Charading/VLT/CAD/drawings/SelfClinchStandoff.png

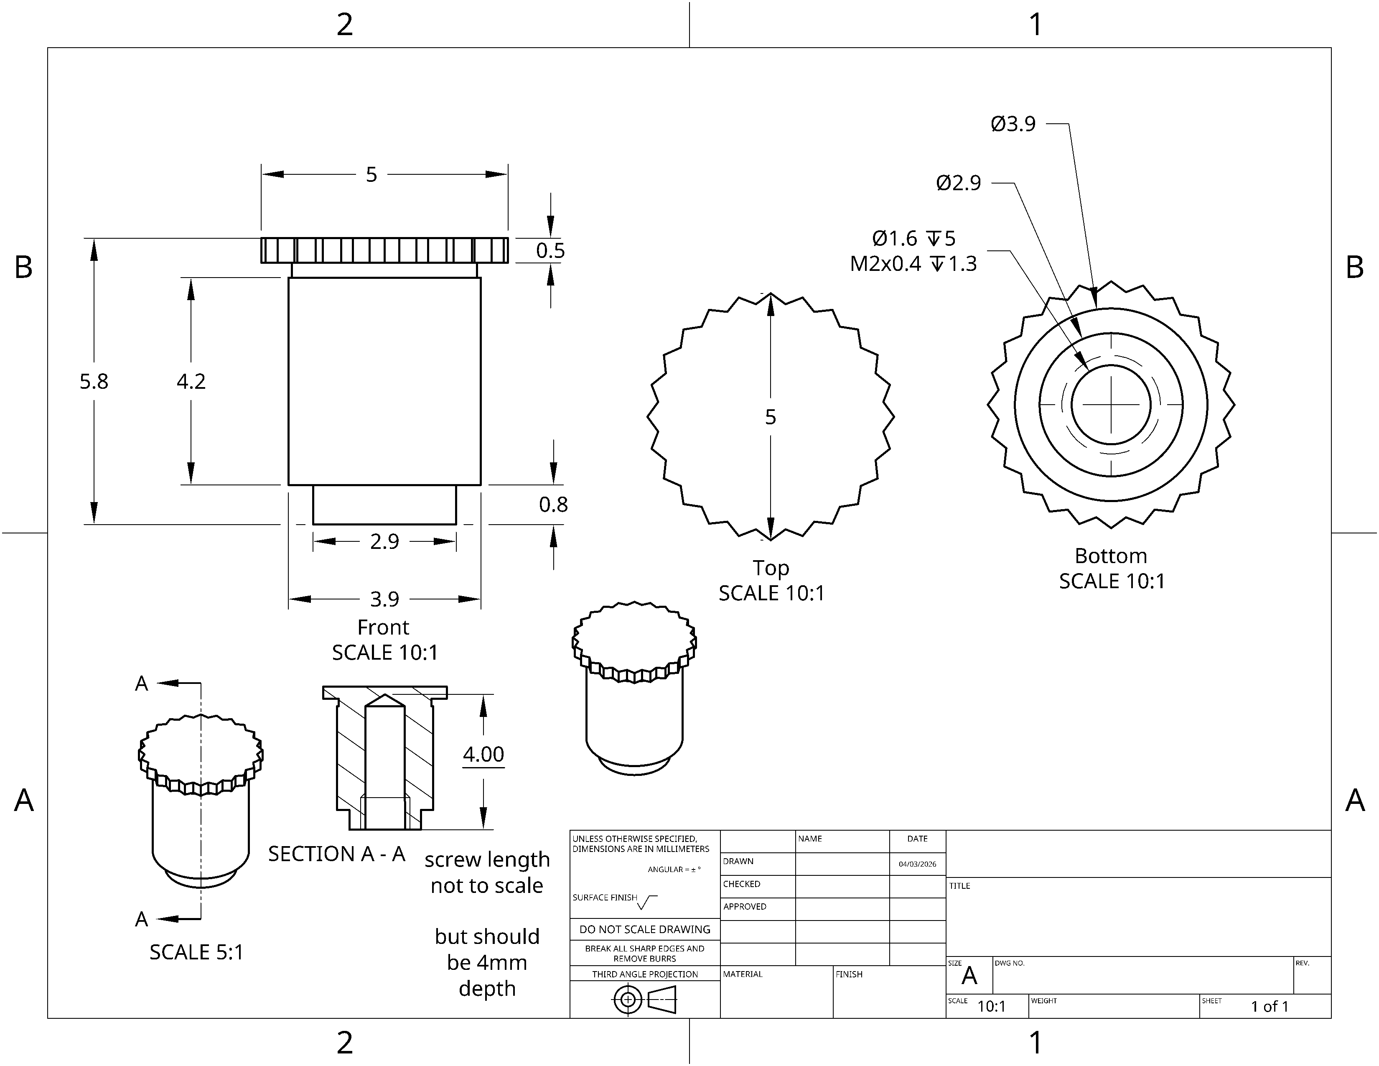
CAD/drawings/SelfClinchStandoff.png
