Charading/VLT/VLT_plate.dxf

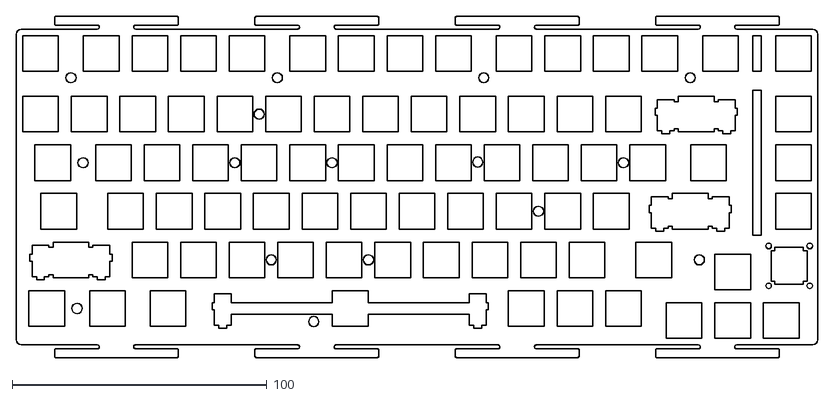
[picture p2: CAD file, 2026-02-06]
VLT_plate.dxf
314.3 x 133.8
