Charading/VLT/CAD/drawings/led cUTOUT.dxf

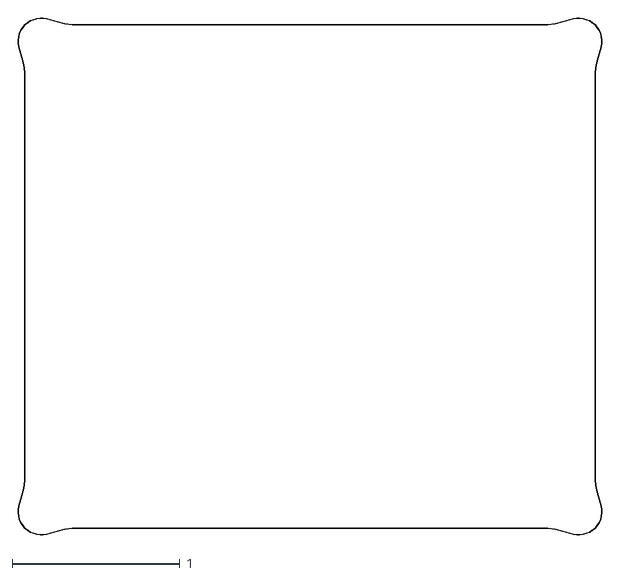
[picture p3: CAD file, 2026-04-27]
CAD/drawings/led cUTOUT.dxf
3.50 x 3.10
