Charading/VLT/(list of files, cad)

Other CAD files:
CAD/drawings/SelfClinchStandoff.dwg
