Charading/VLT/VLT.kicad_sch

## KiCad design VLT.kicad_sch (2026-04-27)

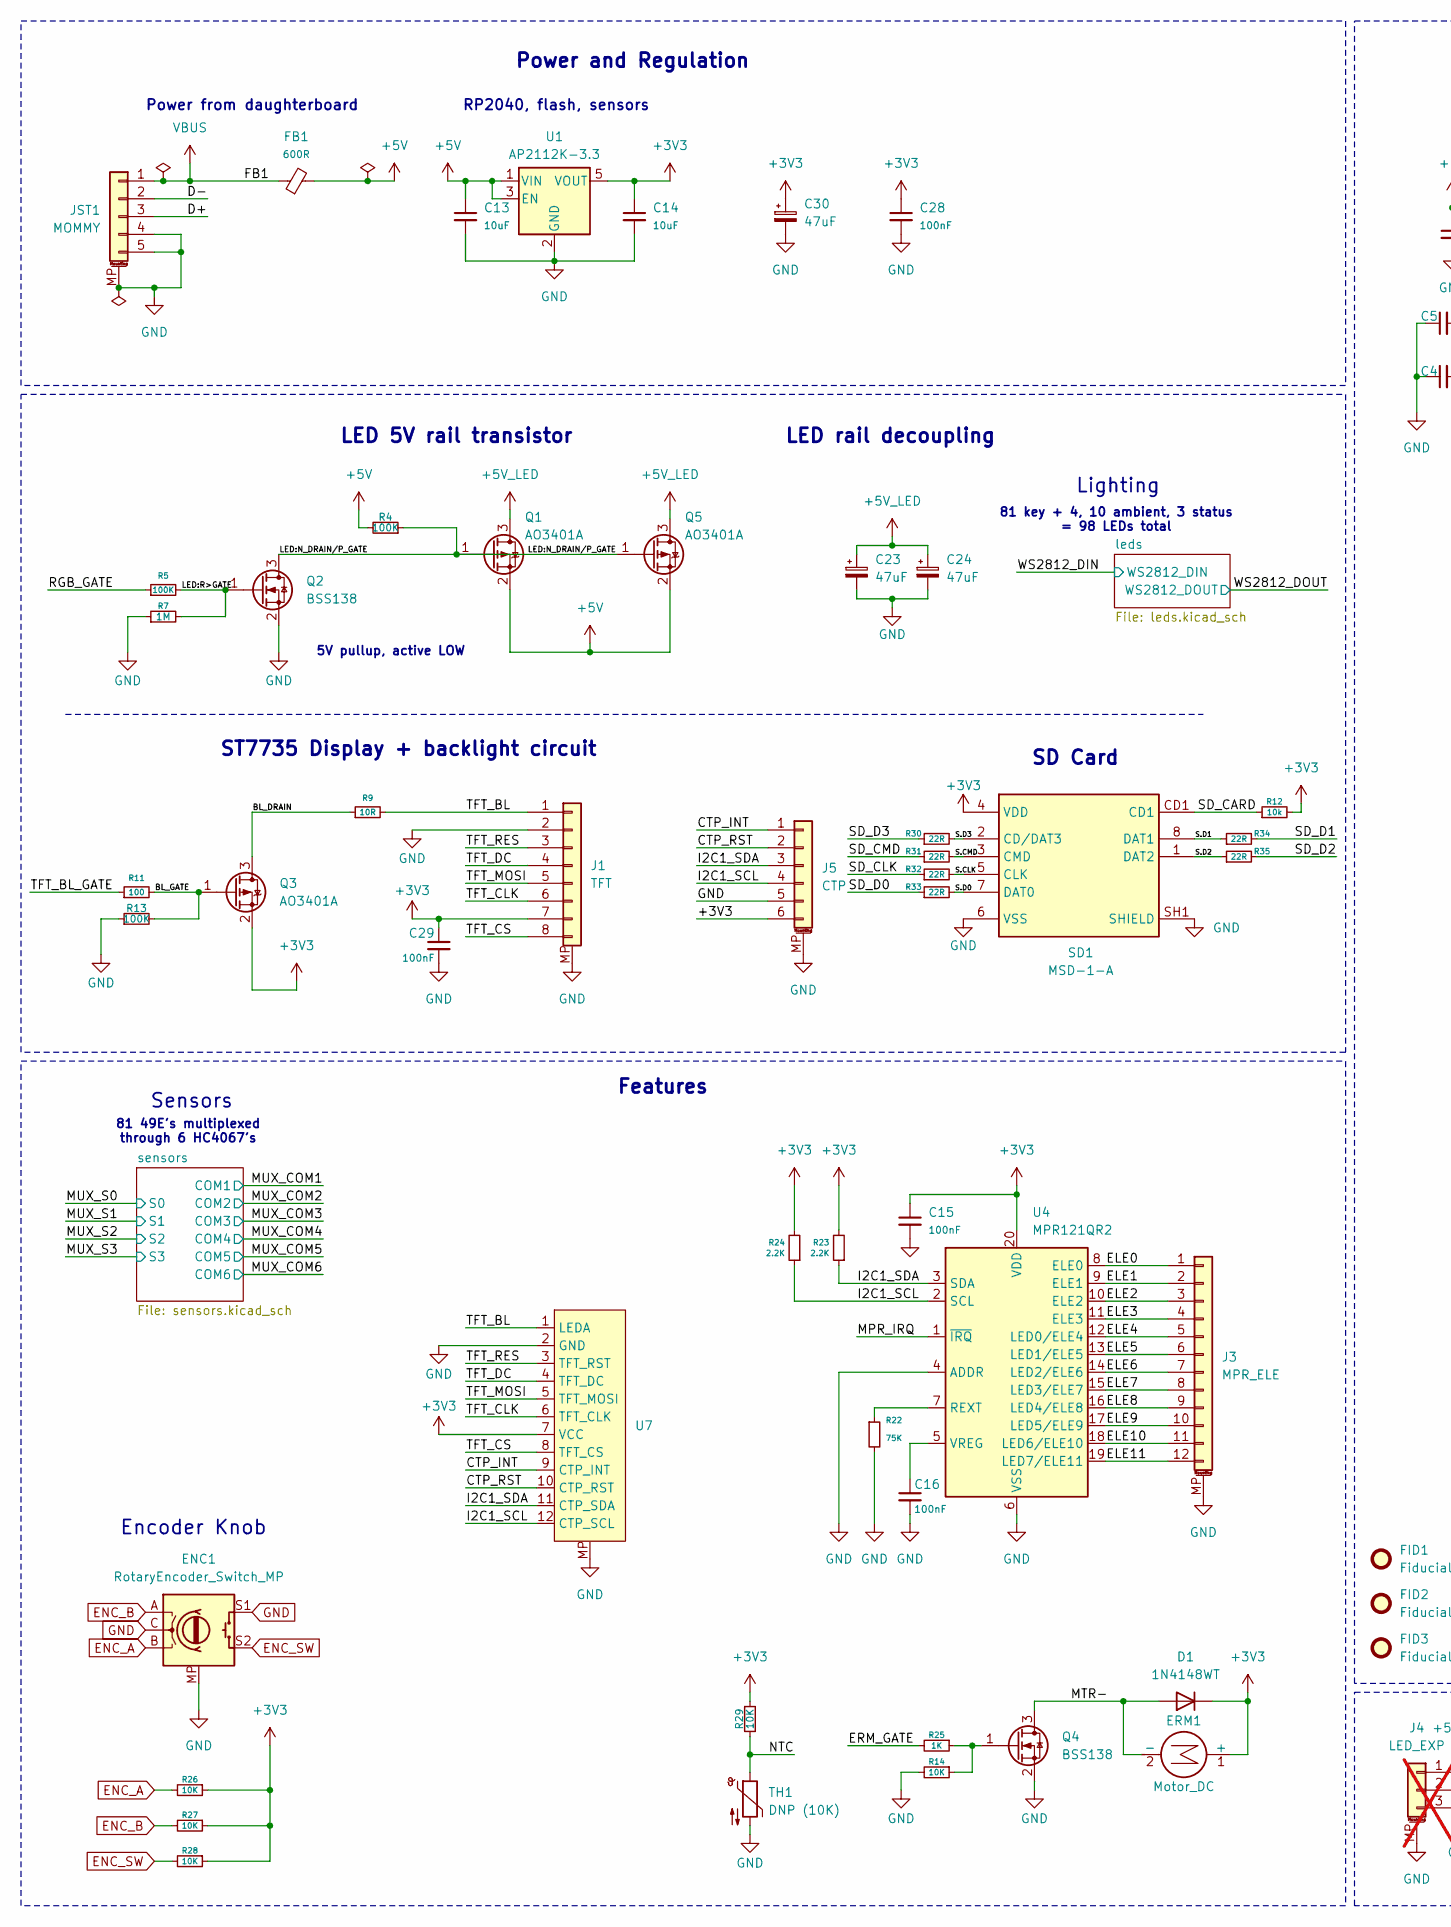
[picture p4: schematic VLT.kicad_sch, part in row 1, column 1]

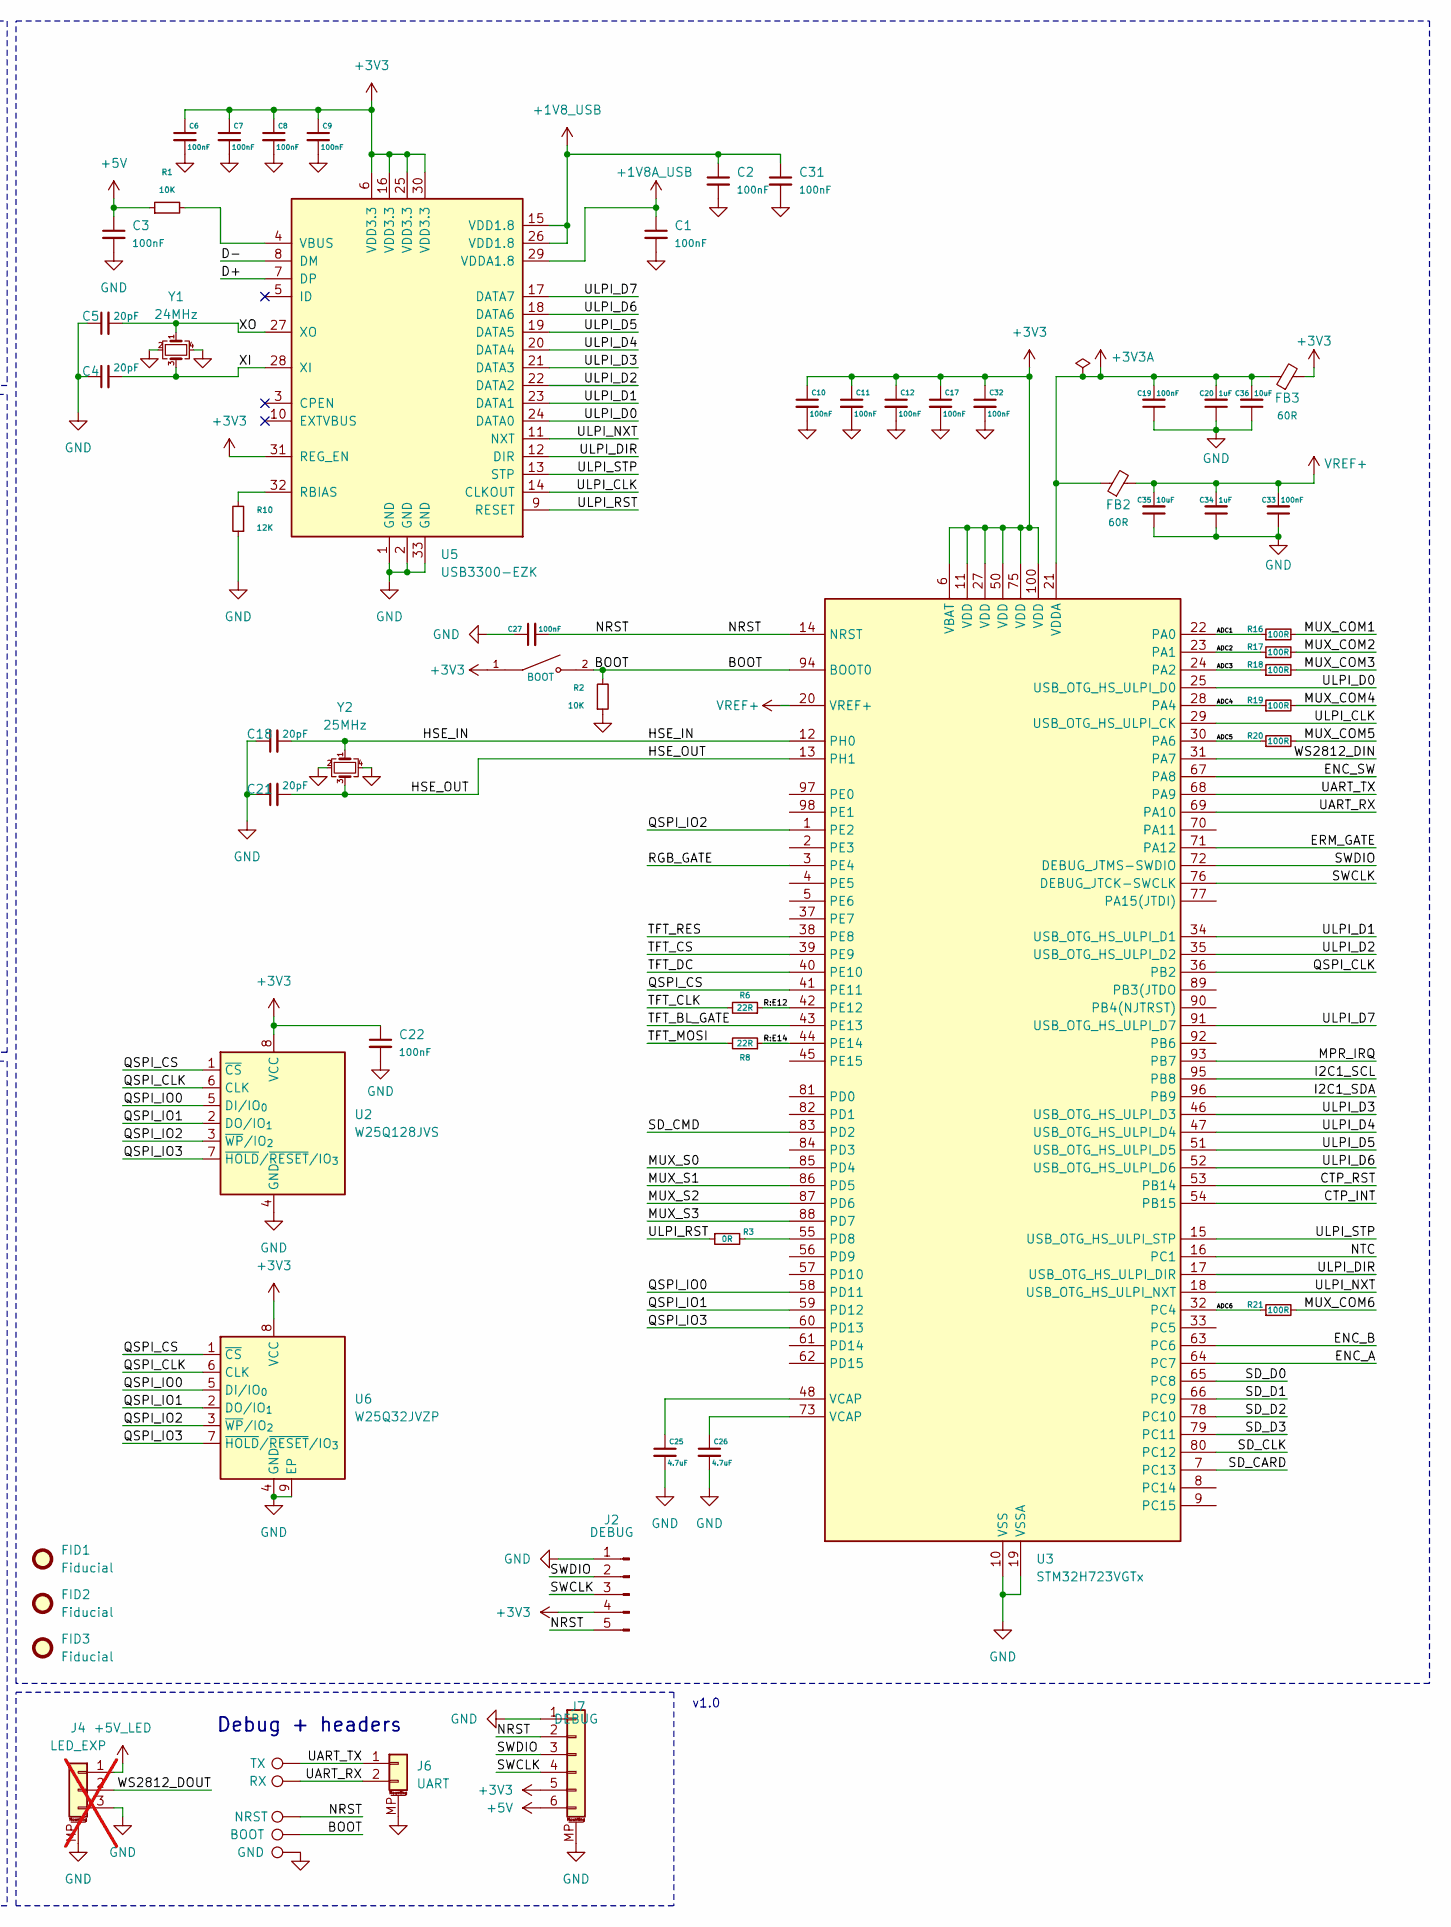
[picture p5: schematic VLT.kicad_sch, part in row 1, column 2]

Parts:
C1, C2, C3, C6, C7, C8, C9, C10, C11, C12, C17, C27, C31, C32: 100nF; C_0402; LCSC C14663
C4, C5, C18, C21: 20pF; C_0402
C13, C14: 10uF; C_0603; LCSC C19702
C15, C16, C28, C29: 100nF; C_0603; LCSC C14663
C19, C33: 100nF; C_0402; Manufacturer Part CL05B104KO5NNNC; LCSC Part Name 100nF ±10% 16V
C20, C34: 1uF; C_0402; Manufacturer Part CL05B104KO5NNNC; LCSC Part Name 100nF ±10% 16V
C22: 100nF; C_0402
C23, C24, C30: 47uF; CP_EIA-3216-12_Kemet-S
C25, C26: 4.7uF; C_0402; LCSC C23733
C35, C36: 10uF; C_0402; Manufacturer Part CL05B104KO5NNNC; LCSC Part Name 100nF ±10% 16V
D1: 1N4148WT; D_SOD-523
ENC1: RotaryEncoder_Switch_MP; RotaryEncoder_Alps_EC11E_Vertical_H20mm_CircularMountingHol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
ERM1: Motor_DC; Coin_Motor_ERM_10mm
FB1: 600R; Ferrite_0805; LCSC C1002
FB2, FB3: 60R; Ferrite_0402
FID1, FID2, FID3: Fiducial; Fiducial_0.5mm_Mask1mm
J1: TFT; XUNPU_FPC-05F-8PH20_1x8-1MP_P0.5mm
J2: DEBUG; SWD_Debug_PinHeader_1x05_P2.54mm; Part Number 1-0401FBV0T
J3: MPR_ELE; XUNPU_FPC-05F-12PH20_1x12-1MP_P0.5mm
J4: LED_EXP; JST_GH_SM03B-GHS-TB_1x03-1MP_P1.25mm_Horizontal; not fitted
J5: CTP; XUNPU_FPC-05F-6PH20_1x6-1MP_P0.5mm
J6: UART; JST_SH_SM02B-SRSS-TB_1x02-1MP_P1.00mm_Horizontal
J7: DEBUG; JST_SH_SM06B-SRSS-TB_1x06-1MP_P1.00mm_Horizontal; Part Number 1-0401FBV0T
JST1: MOMMY; JST_GH_SM05B-GHS-TB_1x05-1MP_P1.25mm_Horizontal
Q1, Q3, Q5: AO3401A; SOT-23
Q2, Q4: BSS138; SOT-23
R1, R2: 10K; R_0402
R3: 0R; R_0402; LCSC C25076
R4, R5, R13: 100K; R_0603
R6, R8, R30, R31, R32, R33, R34, R35: 22R; R_0402
R7: 1M; R_0603
R9: 10R; R_0603; LCSC C22859
R10: 12K; R_0402
R11: 100; R_0603
R12: 10k; R_0603
R14: 10K; R_0402; LCSC C25744
R16, R17, R18, R19, R20, R21: 100R; R_0402; LCSC C25076
R22: 75K; R_0603
R23, R24: 2.2K; R_0402
R25: 1K; R_0402; LCSC C11702
R26, R27, R28, R29: 10K; R_0603; LCSC C25804
S1: BOOT; SW_B3U-1000P
SD1: MSD-1-A; MSD1A; Manufacturer_Part_Number MSD-1-A; Mouser Part Number 179-MSD-1-A
TH1: DNP (10K); R_0603
TP1: TX; TestPoint_Pad_D1.0mm_Minimal
TP2: RX; TestPoint_Pad_D1.0mm_Minimal
TP3: NRST; TestPoint_Pad_D1.0mm_Minimal
TP4: BOOT; TestPoint_Pad_D1.0mm_Minimal
TP5: GND; TestPoint_Pad_D1.0mm_Minimal
U1: AP2112K-3.3; SOT-23-5; LCSC C23380830
U2: W25Q128JVS; SOIC-8_5.3x5.3mm_P1.27mm; LCSC C97521
U3: STM32H723VGTx; LQFP-100_14x14mm_P0.5mm
U4: MPR121QR2; UQFN-20_3x3mm_P0.4mm
U5: USB3300-EZK; QFN-32-1EP_5x5mm_P0.5mm_EP3.45x3.45mm
U6: W25Q32JVZP; WSON-8-1EP_6x5mm_P1.27mm_EP3.4x4.3mm
U7: XUNPU_FPC-05F-12PH20_1x12-1MP_P0.5mm
Y1: 24MHz; Crystal_SMD_3225-4Pin_3.2x2.5mm
Y2: 25MHz; Crystal_SMD_3225-4Pin_3.2x2.5mm

Connections:
+1V8A_USB: C1.1, U5.29 (VDDA1.8)
+1V8_USB: C2.1, C31.1, U5.15 (VDD1.8), U5.26 (VDD1.8)
+3V3: C6.1, C7.1, C8.1, C9.1, C10.1, C11.1, C12.1, C14.1, C15.1, C17.1, C22.1, C28.1, C29.1, C30.1, C32.1, D1.1 (K), ERM1.1 (+), FB3.2, J1.7 (VDD), J2.4, J5.6, J7.5, Q3.2 (S), R12.2, R23.2, R24.2, R26.1, R27.1, R28.1, R29.1, S1.1, SD1.4 (VDD), U1.5 (VOUT), U2.8 (VCC), U3.6 (VBAT), U3.11 (VDD), U3.27 (VDD), U3.50 (VDD), U3.75 (VDD), U3.100 (VDD), U4.20 (VDD), U5.6 (VDD3.3), U5.16 (VDD3.3), U5.25 (VDD3.3), U5.30 (VDD3.3), U5.31 (REG_EN), U6.8 (VCC), U7.7 (VCC)
+3V3A: C19.2, C20.2, C36.2, FB2.1, FB3.1, U3.21 (VDDA)
+5V: C3.1, C13.1, FB1.2, J7.6, Q1.2 (S), Q5.2 (S), R1.1, R4.2, U1.1 (VIN), U1.3 (EN)
+5V_LED: C23.1, C24.1, J4.1, Q1.3 (D), Q5.3 (D)
ADC1: R16.1, U3.22 (PA0)
ADC2: R17.1, U3.23 (PA1)
ADC3: R18.1, U3.24 (PA2)
ADC4: R19.1, U3.28 (PA4)
ADC5: R20.1, U3.30 (PA6)
ADC6: R21.1, U3.32 (PC4)
BL_DRAIN: Q3.3 (D), R9.1
BL_GATE: Q3.1 (G), R11.2, R13.2
BOOT: R2.2, S1.2, TP4.1, U3.94 (BOOT0)
CTP_INT: J5.1, U3.54 (PB15), U7.9 (CTP_INT)
CTP_RST: J5.2, U3.53 (PB14), U7.10 (CTP_RST)
D+: JST1.3, U5.7 (DP)
D-: JST1.2, U5.8 (DM)
ELE0: J3.1, U4.8 (ELE0)
ELE1: J3.2, U4.9 (ELE1)
ELE2: J3.3, U4.10 (ELE2)
ELE3: J3.4, U4.11 (ELE3)
ELE4: J3.5, U4.12 (LED0/ELE4)
ELE5: J3.6, U4.13 (LED1/ELE5)
ELE6: J3.7, U4.14 (LED2/ELE6)
ELE7: J3.8, U4.15 (LED3/ELE7)
ELE8: J3.9, U4.16 (LED4/ELE8)
ELE9: J3.10, U4.17 (LED5/ELE9)
ELE10: J3.11, U4.18 (LED6/ELE10)
ELE11: J3.12, U4.19 (LED7/ELE11)
ENC_A: ENC1.B, R26.2, U3.64 (PC7)
ENC_B: ENC1.A, R27.2, U3.63 (PC6)
ENC_SW: ENC1.S2, R28.2, U3.67 (PA8)
ERM_GATE: R25.2, U3.71 (PA12)
GND: C1.2, C2.2, C3.2, C4.1, C5.1, C6.2, C7.2, C8.2, C9.2, C10.2, C11.2, C12.2, C13.2, C14.2, C15.2, C16.2, C17.2, C18.1, C19.1, C20.1, C21.1, C22.2, C23.2, C24.2, C25.2, C26.2, C27.1, C28.2, C29.2, C30.2, C31.2, C32.2, C33.1, C34.1, C35.1, C36.1, ENC1.C, ENC1.MP, ENC1.S1, J1.2 (GND), J1.MP (Pin_8), J2.1, J3.MP (MountPin), J4.3, J4.MP (MountPin), J5.5, J5.MP (MountPin), J6.MP (MountPin), J7.1, J7.MP (MountPin), JST1.4, JST1.5, JST1.MP (MountPin), Q2.2 (S), Q4.2 (S), R2.1, R7.1, R10.1, R13.1, R14.2, R22.2, SD1.6 (VSS), SD1.9 (GND_1), SD1.10 (GND_2), SD1.11 (GND_3), SD1.12 (GND_4), SD1.SH1 (SHIELD), TH1.2, TP5.1, U1.2 (GND), U2.4 (GND), U3.10 (VSS), U3.19 (VSSA), U3.26 (VSS), U3.49 (VSS), U3.74 (VSS), U3.99 (VSS), U4.4 (ADDR), U4.6 (VSS), U5.1 (GND), U5.2 (GND), U5.33 (GND), U6.4 (GND), U6.9 (EP), U7.2 (GND), U7.MP, Y1.2, Y1.4, Y2.2, Y2.4
HSE_IN: C18.2, U3.12 (PH0), Y2.1
HSE_OUT: C21.2, U3.13 (PH1), Y2.3
I2C1_SCL: J5.4, R24.1, U3.95 (PB8), U4.2 (SCL), U7.12 (CTP_SCL)
I2C1_SDA: J5.3, R23.1, U3.96 (PB9), U4.3 (SDA), U7.11 (CTP_SDA)
LED:N_DRAIN/P_GATE: Q1.1 (G), Q2.3 (D), Q5.1 (G), R4.1
LED:R>GATE: Q2.1 (G), R5.2, R7.2
MPR_IRQ: U3.93 (PB7), U4.1 (~IRQ)
MTR-: D1.2 (A), ERM1.2 (-), Q4.3 (D)
MUX_COM1: R16.2
MUX_COM2: R17.2
MUX_COM3: R18.2
MUX_COM4: R19.2
MUX_COM5: R20.2
MUX_COM6: R21.2
MUX_S0: U3.85 (PD4)
MUX_S1: U3.86 (PD5)
MUX_S2: U3.87 (PD6)
MUX_S3: U3.88 (PD7)
NRST: C27.2, J2.5, J7.2, TP3.1, U3.14 (NRST)
NTC: R29.2, TH1.1, U3.16 (PC1)
unnamed: C16.1, U4.5 (VREG)
unnamed: C25.1, U3.48 (VCAP)
unnamed: C26.1, U3.73 (VCAP)
unnamed: Q4.1 (G), R14.1, R25.1
unnamed: R1.2, U5.4 (VBUS)
unnamed: R3.2, U3.55 (PD8)
unnamed: R10.2, U5.32 (RBIAS)
unnamed: R22.1, U4.7 (REXT)
QSPI_CLK: U2.6 (CLK), U3.36 (PB2), U6.6 (CLK)
QSPI_CS: U2.1 (~CS), U3.41 (PE11), U6.1 (~CS)
QSPI_IO0: U2.5 (DI/IO_{0}), U3.58 (PD11), U6.5 (DI/IO_{0})
QSPI_IO1: U2.2 (DO/IO_{1}), U3.59 (PD12), U6.2 (DO/IO_{1})
QSPI_IO2: U2.3 (~WP/IO_{2}), U3.1 (PE2), U6.3 (~WP/IO_{2})
QSPI_IO3: U2.7 (~HOLD/~RESET/IO_{3}), U3.60 (PD13), U6.7 (~HOLD/~RESET/IO_{3})
R:E12: R6.1, U3.42 (PE12)
R:E14: R8.1, U3.44 (PE14)
RGB_GATE: R5.1, U3.3 (PE4)
S.CLK: R32.2, SD1.5 (CLK)
S.CMD: R31.2, SD1.3 (CMD)
S.D0: R33.2, SD1.7 (DAT0)
S.D1: R34.1, SD1.8 (DAT1)
S.D2: R35.1, SD1.1 (DAT2)
S.D3: R30.2, SD1.2 (CD/DAT3)
SD_CARD: R12.1, SD1.CD1, U3.7 (PC13)
SD_CLK: R32.1, U3.80 (PC12)
SD_CMD: R31.1, U3.83 (PD2)
SD_D0: R33.1, U3.65 (PC8)
SD_D1: R34.2, U3.66 (PC9)
SD_D2: R35.2, U3.78 (PC10)
SD_D3: R30.1, U3.79 (PC11)
SWCLK: J2.3, J7.4, U3.76 (PA14(JTCK)
SWDIO: J2.2, J7.3, U3.72 (PA13(JTMS)
TFT_BL: J1.1 (LEDA), R9.2, U7.1 (LEDA)
TFT_BL_GATE: R11.1, U3.43 (PE13)
TFT_CLK: J1.6 (SCL), R6.2, U7.6 (TFT_CLK)
TFT_CS: J1.8 (CS), U3.39 (PE9), U7.8 (TFT_CS)
TFT_DC: J1.4 (DC), U3.40 (PE10), U7.4 (TFT_DC)
TFT_MOSI: J1.5 (SDA), R8.2, U7.5 (TFT_MOSI)
TFT_RES: J1.3 (RES), U3.38 (PE8), U7.3 (TFT_RST)
UART_RX: J6.2, TP2.1, U3.69 (PA10)
UART_TX: J6.1, TP1.1, U3.68 (PA9)
ULPI_CLK: U3.29 (PA5), U5.14 (CLKOUT)
ULPI_D0: U3.25 (PA3), U5.24 (DATA0)
ULPI_D1: U3.34 (PB0), U5.23 (DATA1)
ULPI_D2: U3.35 (PB1), U5.22 (DATA2)
ULPI_D3: U3.46 (PB10), U5.21 (DATA3)
ULPI_D4: U3.47 (PB11), U5.20 (DATA4)
ULPI_D5: U3.51 (PB12), U5.19 (DATA5)
ULPI_D6: U3.52 (PB13), U5.18 (DATA6)
ULPI_D7: U3.91 (PB5), U5.17 (DATA7)
ULPI_DIR: U3.17 (PC2_C), U5.12 (DIR)
ULPI_NXT: U3.18 (PC3_C), U5.11 (NXT)
ULPI_RST: R3.1, U5.9 (RESET)
ULPI_STP: U3.15 (PC0), U5.13 (STP)
VBUS: FB1.1, JST1.1
VREF+: C33.2, C34.2, C35.2, FB2.2, U3.20 (VREF+)
WS2812_DIN: U3.31 (PA7)
WS2812_DOUT: J4.2
XI: C4.2, U5.28 (XI), Y1.3
XO: C5.2, U5.27 (XO), Y1.1

Notes on the sheet:
LED 5V rail transistor
Power and Regulation
Features
Sensors
RP2040, flash, sensors
ST7735 Display + backlight circuit
v1.0
Debug + headers
5V pullup, active LOW
Power from daughterboard
SD Card
Lighting
LED rail decoupling
81 49E's multiplexed through 6 HC4067's
Encoder Knob
81 key + 4, 10 ambient, 3 status = 98 LEDs total
