Charading/VLT/leds.kicad_sch

## KiCad design leds.kicad_sch (2026-04-27)

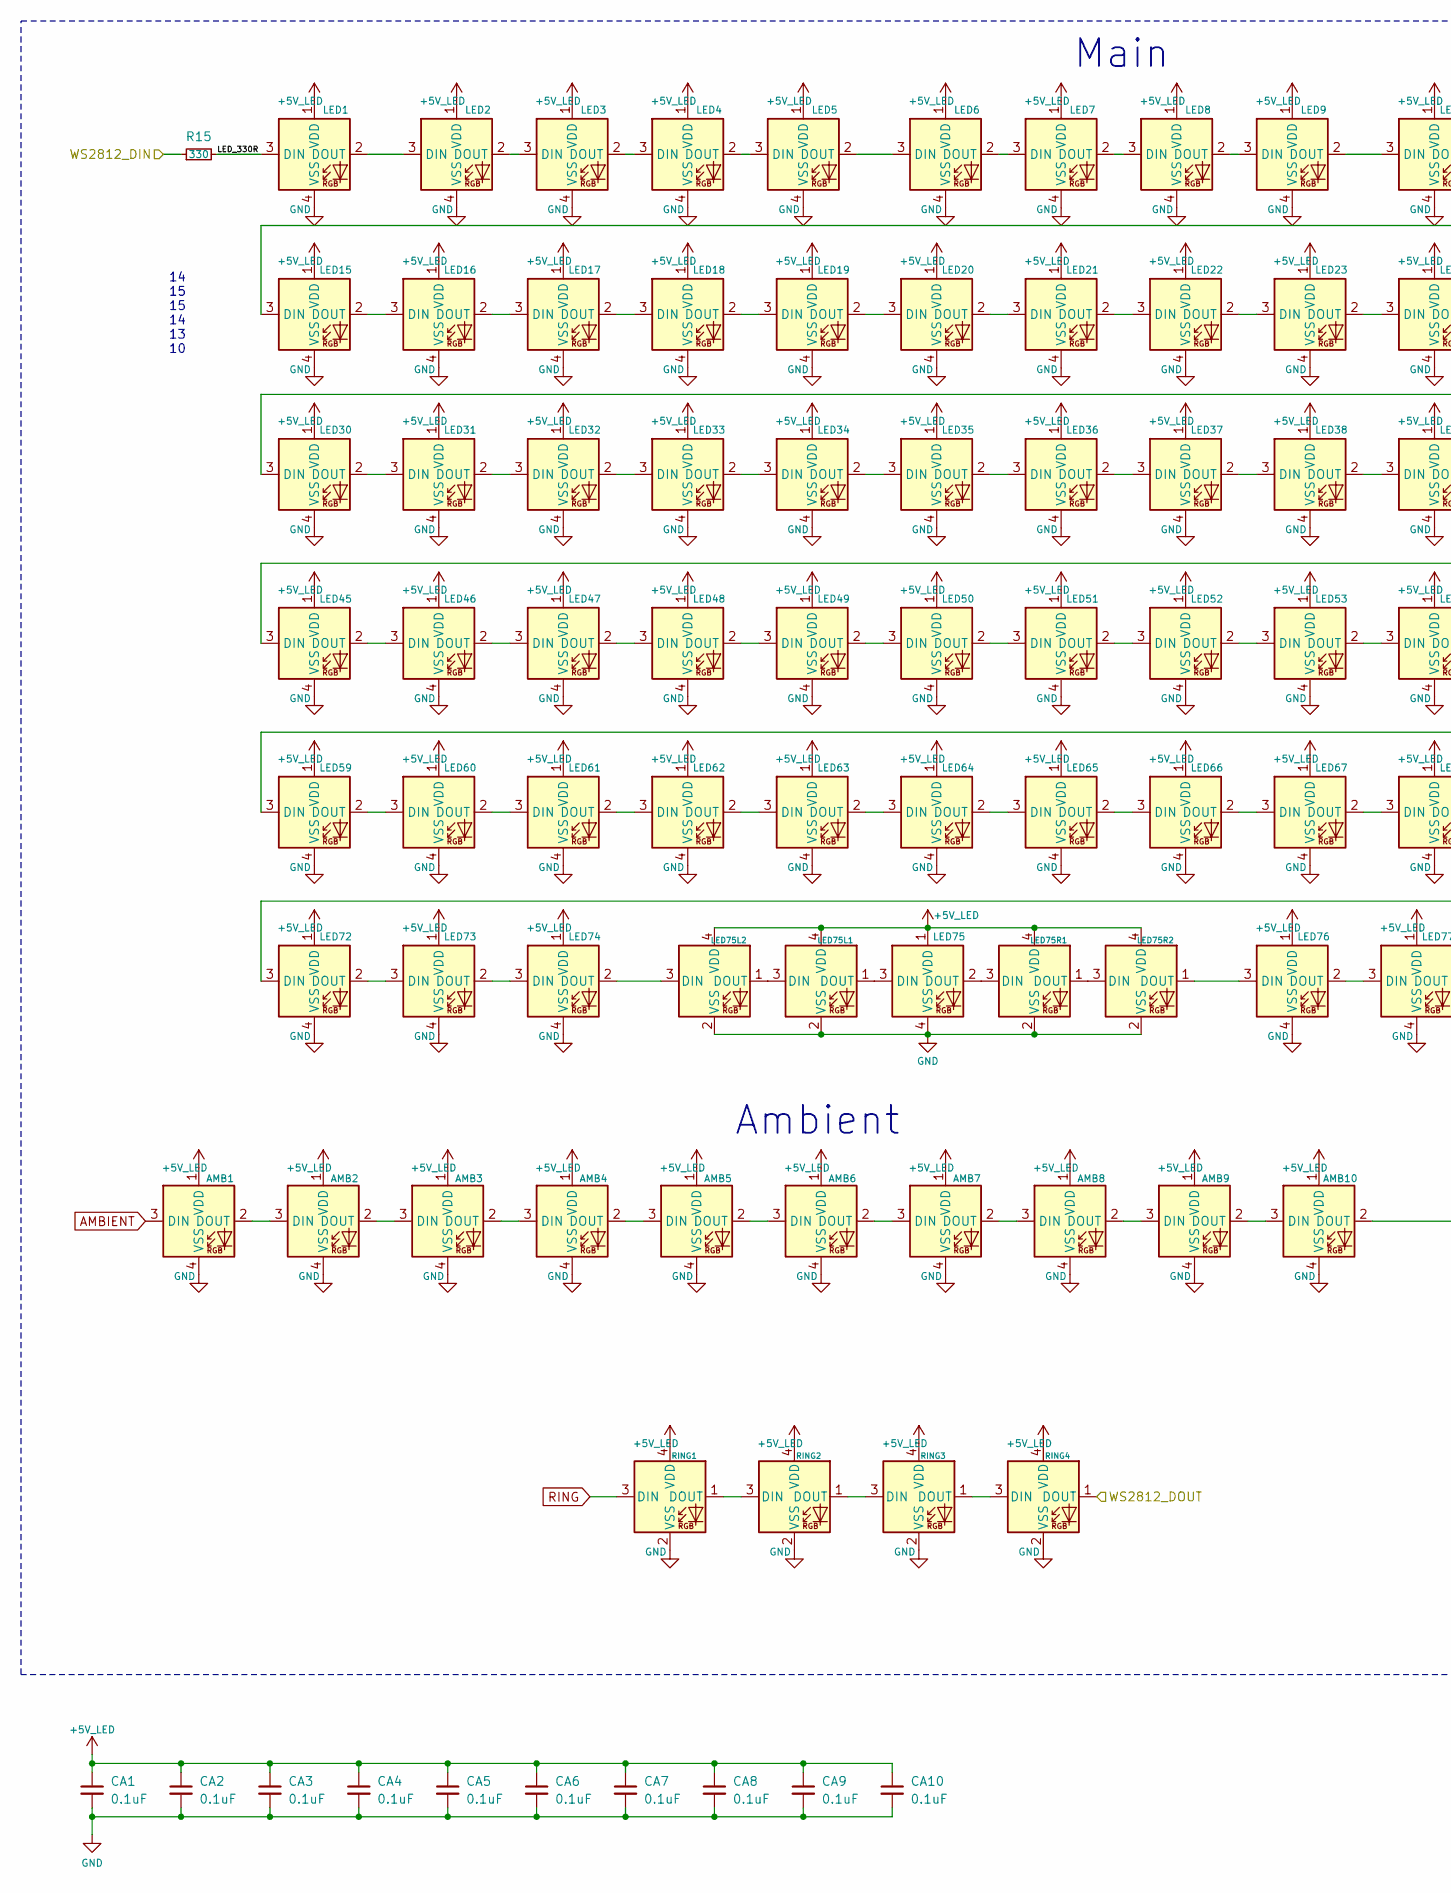
[picture p6: schematic leds.kicad_sch, part in row 1, column 1]

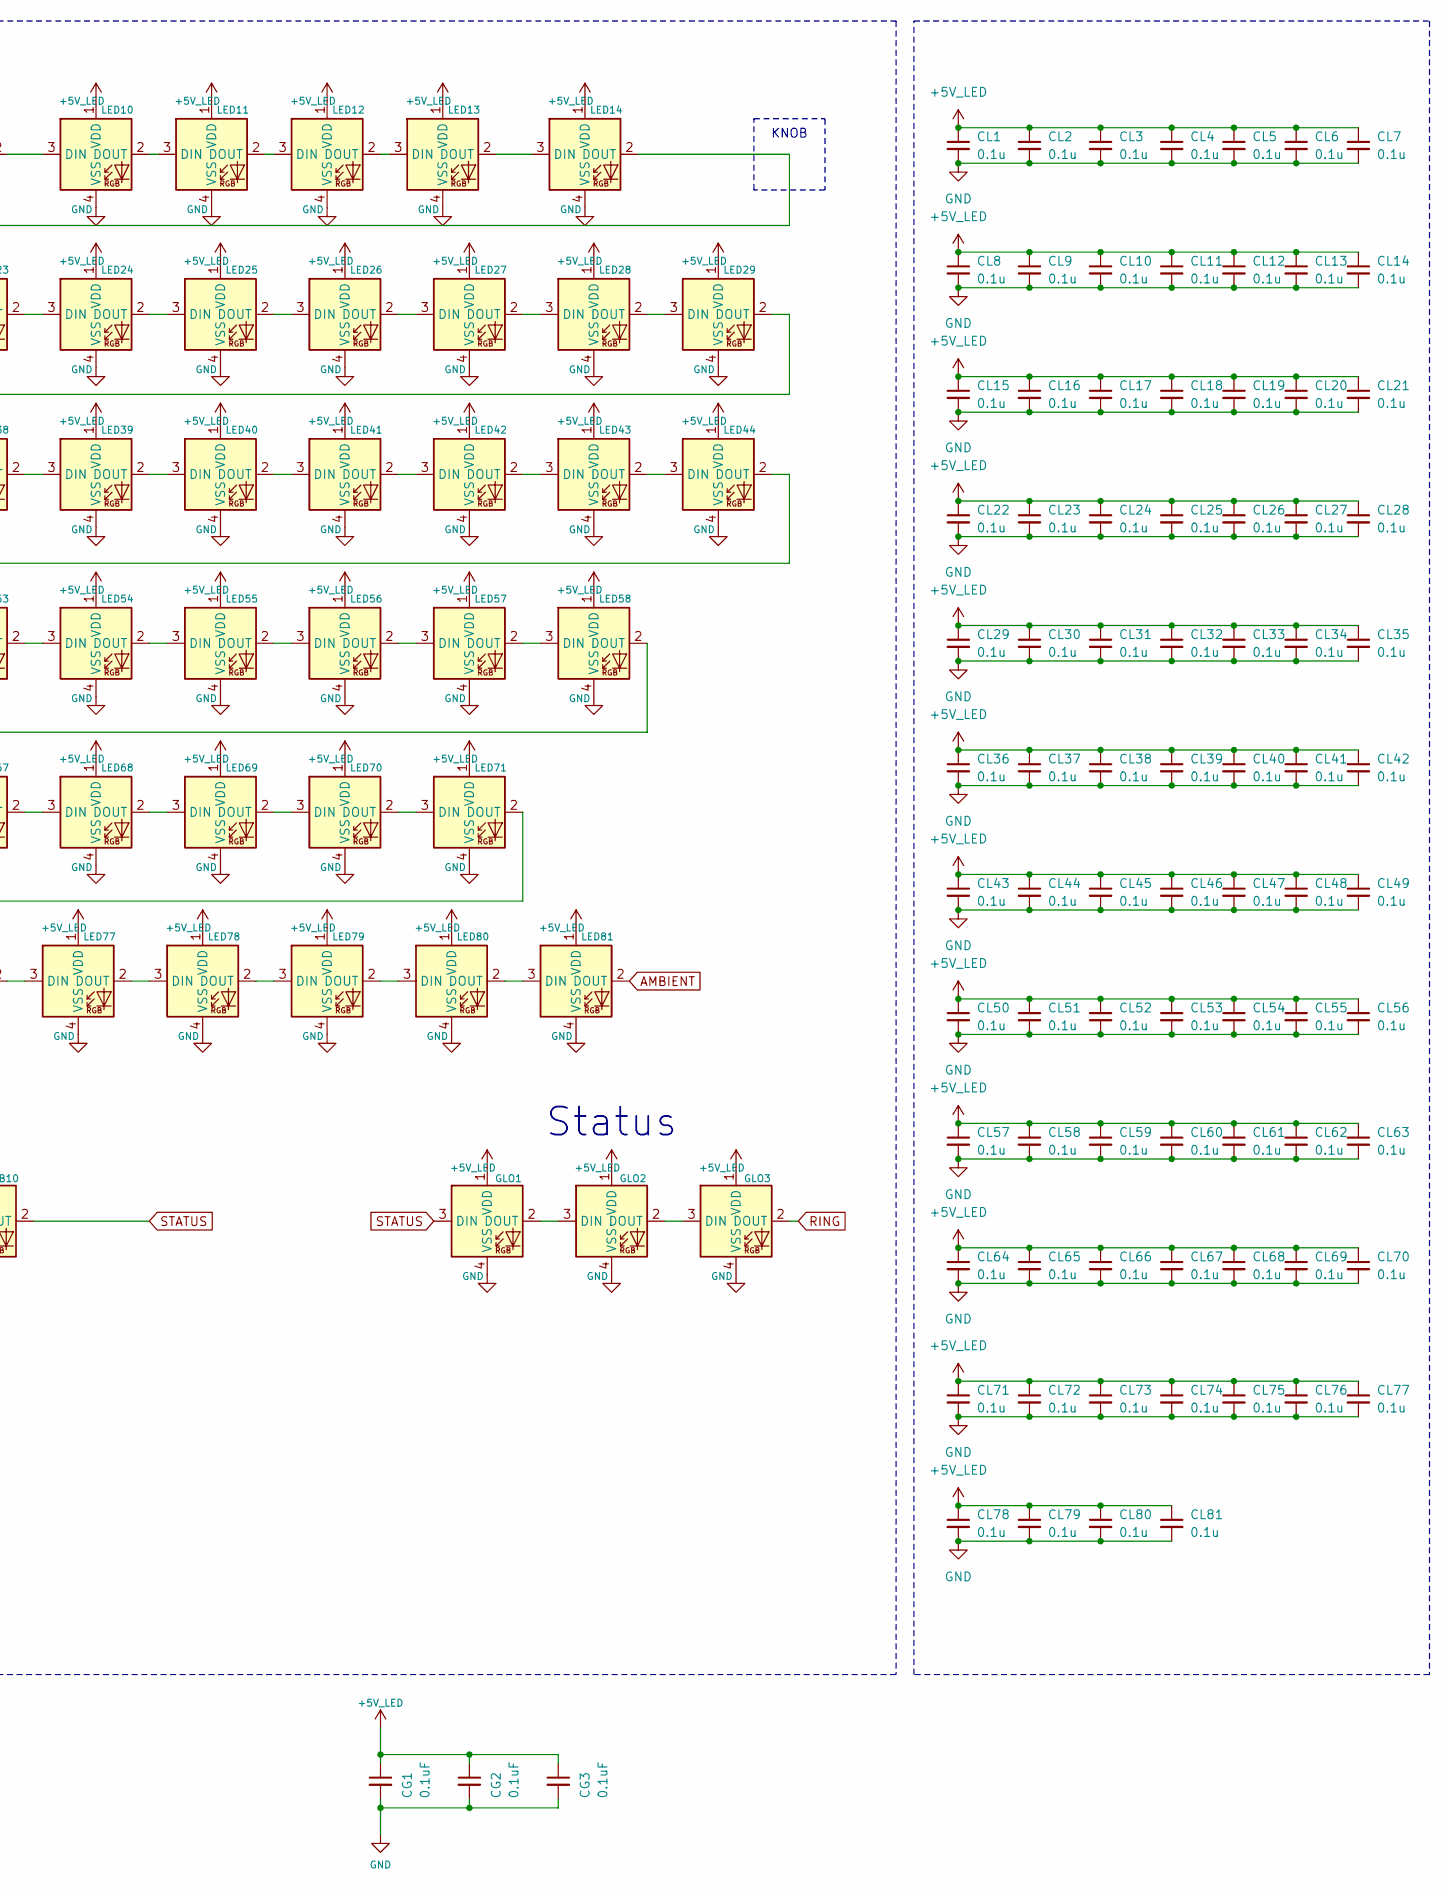
[picture p7: schematic leds.kicad_sch, part in row 1, column 2]

Parts:
AMB1, AMB2, AMB3, AMB4, AMB5, AMB6, AMB7, AMB8, AMB9, AMB10: SK6812; LED_6028R; LCSC C5149201
CA1, CA2, CA3, CA4, CA5, CA6, CA7, CA8, CA9, CA10: 0.1uF; C_0402; LCSC C1525
CG1, CG2, CG3: 0.1uF; C_0402; LCSC C1525
CL1, CL2, CL3, CL4, CL5, CL6, CL7, CL8, CL9, CL10, CL11, CL12, CL13, CL14, CL15, CL16, CL17, CL18, CL19, CL20, CL21, CL22, CL23, CL24, CL25, CL26, CL27, CL28, CL29, CL30, CL31, CL32, CL33, CL34, CL35, CL36, CL37, CL38, CL39, CL40, CL41, CL42, CL43, CL44, CL45, CL46, CL47, CL48, CL49, CL50, CL51, CL52, CL53, CL54, CL55, CL56, CL57, CL58, CL59, CL60, CL61, CL62, CL63, CL64, CL65, CL66, CL67, CL68, CL69, CL70, CL71, CL72, CL73, CL74, CL75, CL76, CL77, CL78, CL79, CL80, CL81: 0.1u; C_0402; LCSC C1525
GLO1, GLO2, GLO3: SK6812; LED_6028R; LCSC C5149201
LED1, LED2, LED3, LED4, LED5, LED6, LED7, LED8, LED9, LED10, LED11, LED12, LED13, LED14, LED15, LED16, LED17, LED18, LED19, LED20, LED21, LED22, LED23, LED24, LED25, LED26, LED27, LED28, LED29, LED30, LED31, LED32, LED33, LED34, LED35, LED36, LED37, LED38, LED39, LED40, LED41, LED42, LED43, LED44, LED45, LED46, LED47, LED48, LED49, LED50, LED51, LED52, LED53, LED54, LED55, LED56, LED57, LED58, LED59, LED60, LED61, LED62, LED63, LED64, LED65, LED66, LED67, LED68, LED69, LED70, LED71, LED72, LED73, LED74, LED75, LED76, LED77, LED78, LED79, LED80, LED81: SK6812; LED_6028R; LCSC C5149201
LED75L1, LED75L2, LED75R1, LED75R2: WS2812_2020; LED_WS2812_2020
R15: 330; R_0603
RING1, RING2, RING3, RING4: WS2812_2020; sk68015-1515

Connections:
+5V_LED: AMB1.1 (VDD), AMB2.1 (VDD), AMB3.1 (VDD), AMB4.1 (VDD), AMB5.1 (VDD), AMB6.1 (VDD), AMB7.1 (VDD), AMB8.1 (VDD), AMB9.1 (VDD), AMB10.1 (VDD), CA1.1, CA2.1, CA3.1, CA4.1, CA5.1, CA6.1, CA7.1, CA8.1, CA9.1, CA10.1, CG1.1, CG2.1, CG3.1, CL1.1, CL2.1, CL3.1, CL4.1, CL5.1, CL6.1, CL7.1, CL8.1, CL9.1, CL10.1, CL11.1, CL12.1, CL13.1, CL14.1, CL15.1, CL16.1, CL17.1, CL18.1, CL19.1, CL20.1, CL21.1, CL22.1, CL23.1, CL24.1, CL25.1, CL26.1, CL27.1, CL28.1, CL29.1, CL30.1, CL31.1, CL32.1, CL33.1, CL34.1, CL35.1, CL36.1, CL37.1, CL38.1, CL39.1, CL40.1, CL41.1, CL42.1, CL43.1, CL44.1, CL45.1, CL46.1, CL47.1, CL48.1, CL49.1, CL50.1, CL51.1, CL52.1, CL53.1, CL54.1, CL55.1, CL56.1, CL57.1, CL58.1, CL59.1, CL60.1, CL61.1, CL62.1, CL63.1, CL64.1, CL65.1, CL66.1, CL67.1, CL68.1, CL69.1, CL70.1, CL71.1, CL72.1, CL73.1, CL74.1, CL75.1, CL76.1, CL77.1, CL78.1, CL79.1, CL80.1, CL81.1, GLO1.1 (VDD), GLO2.1 (VDD), GLO3.1 (VDD), LED1.1 (VDD), LED2.1 (VDD), LED3.1 (VDD), LED4.1 (VDD), LED5.1 (VDD), LED6.1 (VDD), LED7.1 (VDD), LED8.1 (VDD), LED9.1 (VDD), LED10.1 (VDD), LED11.1 (VDD), LED12.1 (VDD), LED13.1 (VDD), LED14.1 (VDD), LED15.1 (VDD), LED16.1 (VDD), LED17.1 (VDD), LED18.1 (VDD), LED19.1 (VDD), LED20.1 (VDD), LED21.1 (VDD), LED22.1 (VDD), LED23.1 (VDD), LED24.1 (VDD), LED25.1 (VDD), LED26.1 (VDD), LED27.1 (VDD), LED28.1 (VDD), LED29.1 (VDD), LED30.1 (VDD), LED31.1 (VDD), LED32.1 (VDD), LED33.1 (VDD), LED34.1 (VDD), LED35.1 (VDD), LED36.1 (VDD), LED37.1 (VDD), LED38.1 (VDD), LED39.1 (VDD), LED40.1 (VDD), LED41.1 (VDD), LED42.1 (VDD), LED43.1 (VDD), LED44.1 (VDD), LED45.1 (VDD), LED46.1 (VDD), LED47.1 (VDD), LED48.1 (VDD), LED49.1 (VDD), LED50.1 (VDD), LED51.1 (VDD), LED52.1 (VDD), LED53.1 (VDD), LED54.1 (VDD), LED55.1 (VDD), LED56.1 (VDD), LED57.1 (VDD), LED58.1 (VDD), LED59.1 (VDD), LED60.1 (VDD), LED61.1 (VDD), LED62.1 (VDD), LED63.1 (VDD), LED64.1 (VDD), LED65.1 (VDD), LED66.1 (VDD), LED67.1 (VDD), LED68.1 (VDD), LED69.1 (VDD), LED70.1 (VDD), LED71.1 (VDD), LED72.1 (VDD), LED73.1 (VDD), LED74.1 (VDD), LED75.1 (VDD), LED75L1.4 (VDD), LED75L2.4 (VDD), LED75R1.4 (VDD), LED75R2.4 (VDD), LED76.1 (VDD), LED77.1 (VDD), LED78.1 (VDD), LED79.1 (VDD), LED80.1 (VDD), LED81.1 (VDD), RING1.4 (VDD), RING2.4 (VDD), RING3.4 (VDD), RING4.4 (VDD)
AMBIENT: AMB1.3 (DIN), LED81.2 (DOUT)
GND: AMB1.4 (VSS), AMB2.4 (VSS), AMB3.4 (VSS), AMB4.4 (VSS), AMB5.4 (VSS), AMB6.4 (VSS), AMB7.4 (VSS), AMB8.4 (VSS), AMB9.4 (VSS), AMB10.4 (VSS), CA1.2, CA2.2, CA3.2, CA4.2, CA5.2, CA6.2, CA7.2, CA8.2, CA9.2, CA10.2, CG1.2, CG2.2, CG3.2, CL1.2, CL2.2, CL3.2, CL4.2, CL5.2, CL6.2, CL7.2, CL8.2, CL9.2, CL10.2, CL11.2, CL12.2, CL13.2, CL14.2, CL15.2, CL16.2, CL17.2, CL18.2, CL19.2, CL20.2, CL21.2, CL22.2, CL23.2, CL24.2, CL25.2, CL26.2, CL27.2, CL28.2, CL29.2, CL30.2, CL31.2, CL32.2, CL33.2, CL34.2, CL35.2, CL36.2, CL37.2, CL38.2, CL39.2, CL40.2, CL41.2, CL42.2, CL43.2, CL44.2, CL45.2, CL46.2, CL47.2, CL48.2, CL49.2, CL50.2, CL51.2, CL52.2, CL53.2, CL54.2, CL55.2, CL56.2, CL57.2, CL58.2, CL59.2, CL60.2, CL61.2, CL62.2, CL63.2, CL64.2, CL65.2, CL66.2, CL67.2, CL68.2, CL69.2, CL70.2, CL71.2, CL72.2, CL73.2, CL74.2, CL75.2, CL76.2, CL77.2, CL78.2, CL79.2, CL80.2, CL81.2, GLO1.4 (VSS), GLO2.4 (VSS), GLO3.4 (VSS), LED1.4 (VSS), LED2.4 (VSS), LED3.4 (VSS), LED4.4 (VSS), LED5.4 (VSS), LED6.4 (VSS), LED7.4 (VSS), LED8.4 (VSS), LED9.4 (VSS), LED10.4 (VSS), LED11.4 (VSS), LED12.4 (VSS), LED13.4 (VSS), LED14.4 (VSS), LED15.4 (VSS), LED16.4 (VSS), LED17.4 (VSS), LED18.4 (VSS), LED19.4 (VSS), LED20.4 (VSS), LED21.4 (VSS), LED22.4 (VSS), LED23.4 (VSS), LED24.4 (VSS), LED25.4 (VSS), LED26.4 (VSS), LED27.4 (VSS), LED28.4 (VSS), LED29.4 (VSS), LED30.4 (VSS), LED31.4 (VSS), LED32.4 (VSS), LED33.4 (VSS), LED34.4 (VSS), LED35.4 (VSS), LED36.4 (VSS), LED37.4 (VSS), LED38.4 (VSS), LED39.4 (VSS), LED40.4 (VSS), LED41.4 (VSS), LED42.4 (VSS), LED43.4 (VSS), LED44.4 (VSS), LED45.4 (VSS), LED46.4 (VSS), LED47.4 (VSS), LED48.4 (VSS), LED49.4 (VSS), LED50.4 (VSS), LED51.4 (VSS), LED52.4 (VSS), LED53.4 (VSS), LED54.4 (VSS), LED55.4 (VSS), LED56.4 (VSS), LED57.4 (VSS), LED58.4 (VSS), LED59.4 (VSS), LED60.4 (VSS), LED61.4 (VSS), LED62.4 (VSS), LED63.4 (VSS), LED64.4 (VSS), LED65.4 (VSS), LED66.4 (VSS), LED67.4 (VSS), LED68.4 (VSS), LED69.4 (VSS), LED70.4 (VSS), LED71.4 (VSS), LED72.4 (VSS), LED73.4 (VSS), LED74.4 (VSS), LED75.4 (VSS), LED75L1.2 (VSS), LED75L2.2 (VSS), LED75R1.2 (VSS), LED75R2.2 (VSS), LED76.4 (VSS), LED77.4 (VSS), LED78.4 (VSS), LED79.4 (VSS), LED80.4 (VSS), LED81.4 (VSS), RING1.2 (VSS), RING2.2 (VSS), RING3.2 (VSS), RING4.2 (VSS)
LED_330R: LED1.3 (DIN), R15.2
unnamed: AMB1.2 (DOUT), AMB2.3 (DIN)
unnamed: AMB2.2 (DOUT), AMB3.3 (DIN)
unnamed: AMB3.2 (DOUT), AMB4.3 (DIN)
unnamed: AMB4.2 (DOUT), AMB5.3 (DIN)
unnamed: AMB5.2 (DOUT), AMB6.3 (DIN)
unnamed: AMB6.2 (DOUT), AMB7.3 (DIN)
unnamed: AMB7.2 (DOUT), AMB8.3 (DIN)
unnamed: AMB8.2 (DOUT), AMB9.3 (DIN)
unnamed: AMB9.2 (DOUT), AMB10.3 (DIN)
unnamed: GLO1.2 (DOUT), GLO2.3 (DIN)
unnamed: GLO2.2 (DOUT), GLO3.3 (DIN)
unnamed: LED1.2 (DOUT), LED2.3 (DIN)
unnamed: LED2.2 (DOUT), LED3.3 (DIN)
unnamed: LED3.2 (DOUT), LED4.3 (DIN)
unnamed: LED4.2 (DOUT), LED5.3 (DIN)
unnamed: LED5.2 (DOUT), LED6.3 (DIN)
unnamed: LED6.2 (DOUT), LED7.3 (DIN)
unnamed: LED7.2 (DOUT), LED8.3 (DIN)
unnamed: LED8.2 (DOUT), LED9.3 (DIN)
unnamed: LED10.2 (DOUT), LED11.3 (DIN)
unnamed: LED9.2 (DOUT), LED10.3 (DIN)
unnamed: LED11.2 (DOUT), LED12.3 (DIN)
unnamed: LED12.2 (DOUT), LED13.3 (DIN)
unnamed: LED13.2 (DOUT), LED14.3 (DIN)
unnamed: LED14.2 (DOUT), LED15.3 (DIN)
unnamed: LED15.2 (DOUT), LED16.3 (DIN)
unnamed: LED16.2 (DOUT), LED17.3 (DIN)
unnamed: LED17.2 (DOUT), LED18.3 (DIN)
unnamed: LED18.2 (DOUT), LED19.3 (DIN)
unnamed: LED19.2 (DOUT), LED20.3 (DIN)
unnamed: LED20.2 (DOUT), LED21.3 (DIN)
unnamed: LED21.2 (DOUT), LED22.3 (DIN)
unnamed: LED22.2 (DOUT), LED23.3 (DIN)
unnamed: LED23.2 (DOUT), LED24.3 (DIN)
unnamed: LED24.2 (DOUT), LED25.3 (DIN)
unnamed: LED25.2 (DOUT), LED26.3 (DIN)
unnamed: LED26.2 (DOUT), LED27.3 (DIN)
unnamed: LED27.2 (DOUT), LED28.3 (DIN)
unnamed: LED28.2 (DOUT), LED29.3 (DIN)
unnamed: LED29.2 (DOUT), LED30.3 (DIN)
unnamed: LED30.2 (DOUT), LED31.3 (DIN)
unnamed: LED31.2 (DOUT), LED32.3 (DIN)
unnamed: LED32.2 (DOUT), LED33.3 (DIN)
unnamed: LED33.2 (DOUT), LED34.3 (DIN)
unnamed: LED34.2 (DOUT), LED35.3 (DIN)
unnamed: LED35.2 (DOUT), LED36.3 (DIN)
unnamed: LED36.2 (DOUT), LED37.3 (DIN)
unnamed: LED37.2 (DOUT), LED38.3 (DIN)
unnamed: LED38.2 (DOUT), LED39.3 (DIN)
unnamed: LED39.2 (DOUT), LED40.3 (DIN)
unnamed: LED40.2 (DOUT), LED41.3 (DIN)
unnamed: LED41.2 (DOUT), LED42.3 (DIN)
unnamed: LED42.2 (DOUT), LED43.3 (DIN)
unnamed: LED43.2 (DOUT), LED44.3 (DIN)
unnamed: LED44.2 (DOUT), LED45.3 (DIN)
unnamed: LED45.2 (DOUT), LED46.3 (DIN)
unnamed: LED46.2 (DOUT), LED47.3 (DIN)
unnamed: LED47.2 (DOUT), LED48.3 (DIN)
unnamed: LED48.2 (DOUT), LED49.3 (DIN)
unnamed: LED49.2 (DOUT), LED50.3 (DIN)
unnamed: LED50.2 (DOUT), LED51.3 (DIN)
unnamed: LED51.2 (DOUT), LED52.3 (DIN)
unnamed: LED52.2 (DOUT), LED53.3 (DIN)
unnamed: LED53.2 (DOUT), LED54.3 (DIN)
unnamed: LED54.2 (DOUT), LED55.3 (DIN)
unnamed: LED55.2 (DOUT), LED56.3 (DIN)
unnamed: LED56.2 (DOUT), LED57.3 (DIN)
unnamed: LED57.2 (DOUT), LED58.3 (DIN)
unnamed: LED58.2 (DOUT), LED59.3 (DIN)
unnamed: LED59.2 (DOUT), LED60.3 (DIN)
unnamed: LED60.2 (DOUT), LED61.3 (DIN)
unnamed: LED61.2 (DOUT), LED62.3 (DIN)
unnamed: LED62.2 (DOUT), LED63.3 (DIN)
unnamed: LED63.2 (DOUT), LED64.3 (DIN)
unnamed: LED64.2 (DOUT), LED65.3 (DIN)
unnamed: LED65.2 (DOUT), LED66.3 (DIN)
unnamed: LED66.2 (DOUT), LED67.3 (DIN)
unnamed: LED67.2 (DOUT), LED68.3 (DIN)
unnamed: LED68.2 (DOUT), LED69.3 (DIN)
unnamed: LED69.2 (DOUT), LED70.3 (DIN)
unnamed: LED70.2 (DOUT), LED71.3 (DIN)
unnamed: LED71.2 (DOUT), LED72.3 (DIN)
unnamed: LED72.2 (DOUT), LED73.3 (DIN)
unnamed: LED73.2 (DOUT), LED74.3 (DIN)
unnamed: LED74.2 (DOUT), LED75L2.3 (DIN)
unnamed: LED75.2 (DOUT), LED75R1.3 (DIN)
unnamed: LED75.3 (DIN), LED75L1.1 (DOUT)
unnamed: LED75L1.3 (DIN), LED75L2.1 (DOUT)
unnamed: LED75R1.1 (DOUT), LED75R2.3 (DIN)
unnamed: LED75R2.1 (DOUT), LED76.3 (DIN)
unnamed: LED76.2 (DOUT), LED77.3 (DIN)
unnamed: LED77.2 (DOUT), LED78.3 (DIN)
unnamed: LED78.2 (DOUT), LED79.3 (DIN)
unnamed: LED79.2 (DOUT), LED80.3 (DIN)
unnamed: LED80.2 (DOUT), LED81.3 (DIN)
unnamed: RING1.1 (DOUT), RING2.3 (DIN)
unnamed: RING2.1 (DOUT), RING3.3 (DIN)
unnamed: RING3.1 (DOUT), RING4.3 (DIN)
RING: GLO3.2 (DOUT), RING1.3 (DIN)
STATUS: AMB10.2 (DOUT), GLO1.3 (DIN)
WS2812_DIN: R15.1
WS2812_DOUT: RING4.1 (DOUT)

Notes on the sheet:
Status
Main
14 15 15 14 13 10
KNOB
Ambient
