Charading/VLT/sensors.kicad_sch

## KiCad design sensors.kicad_sch (2026-04-27)

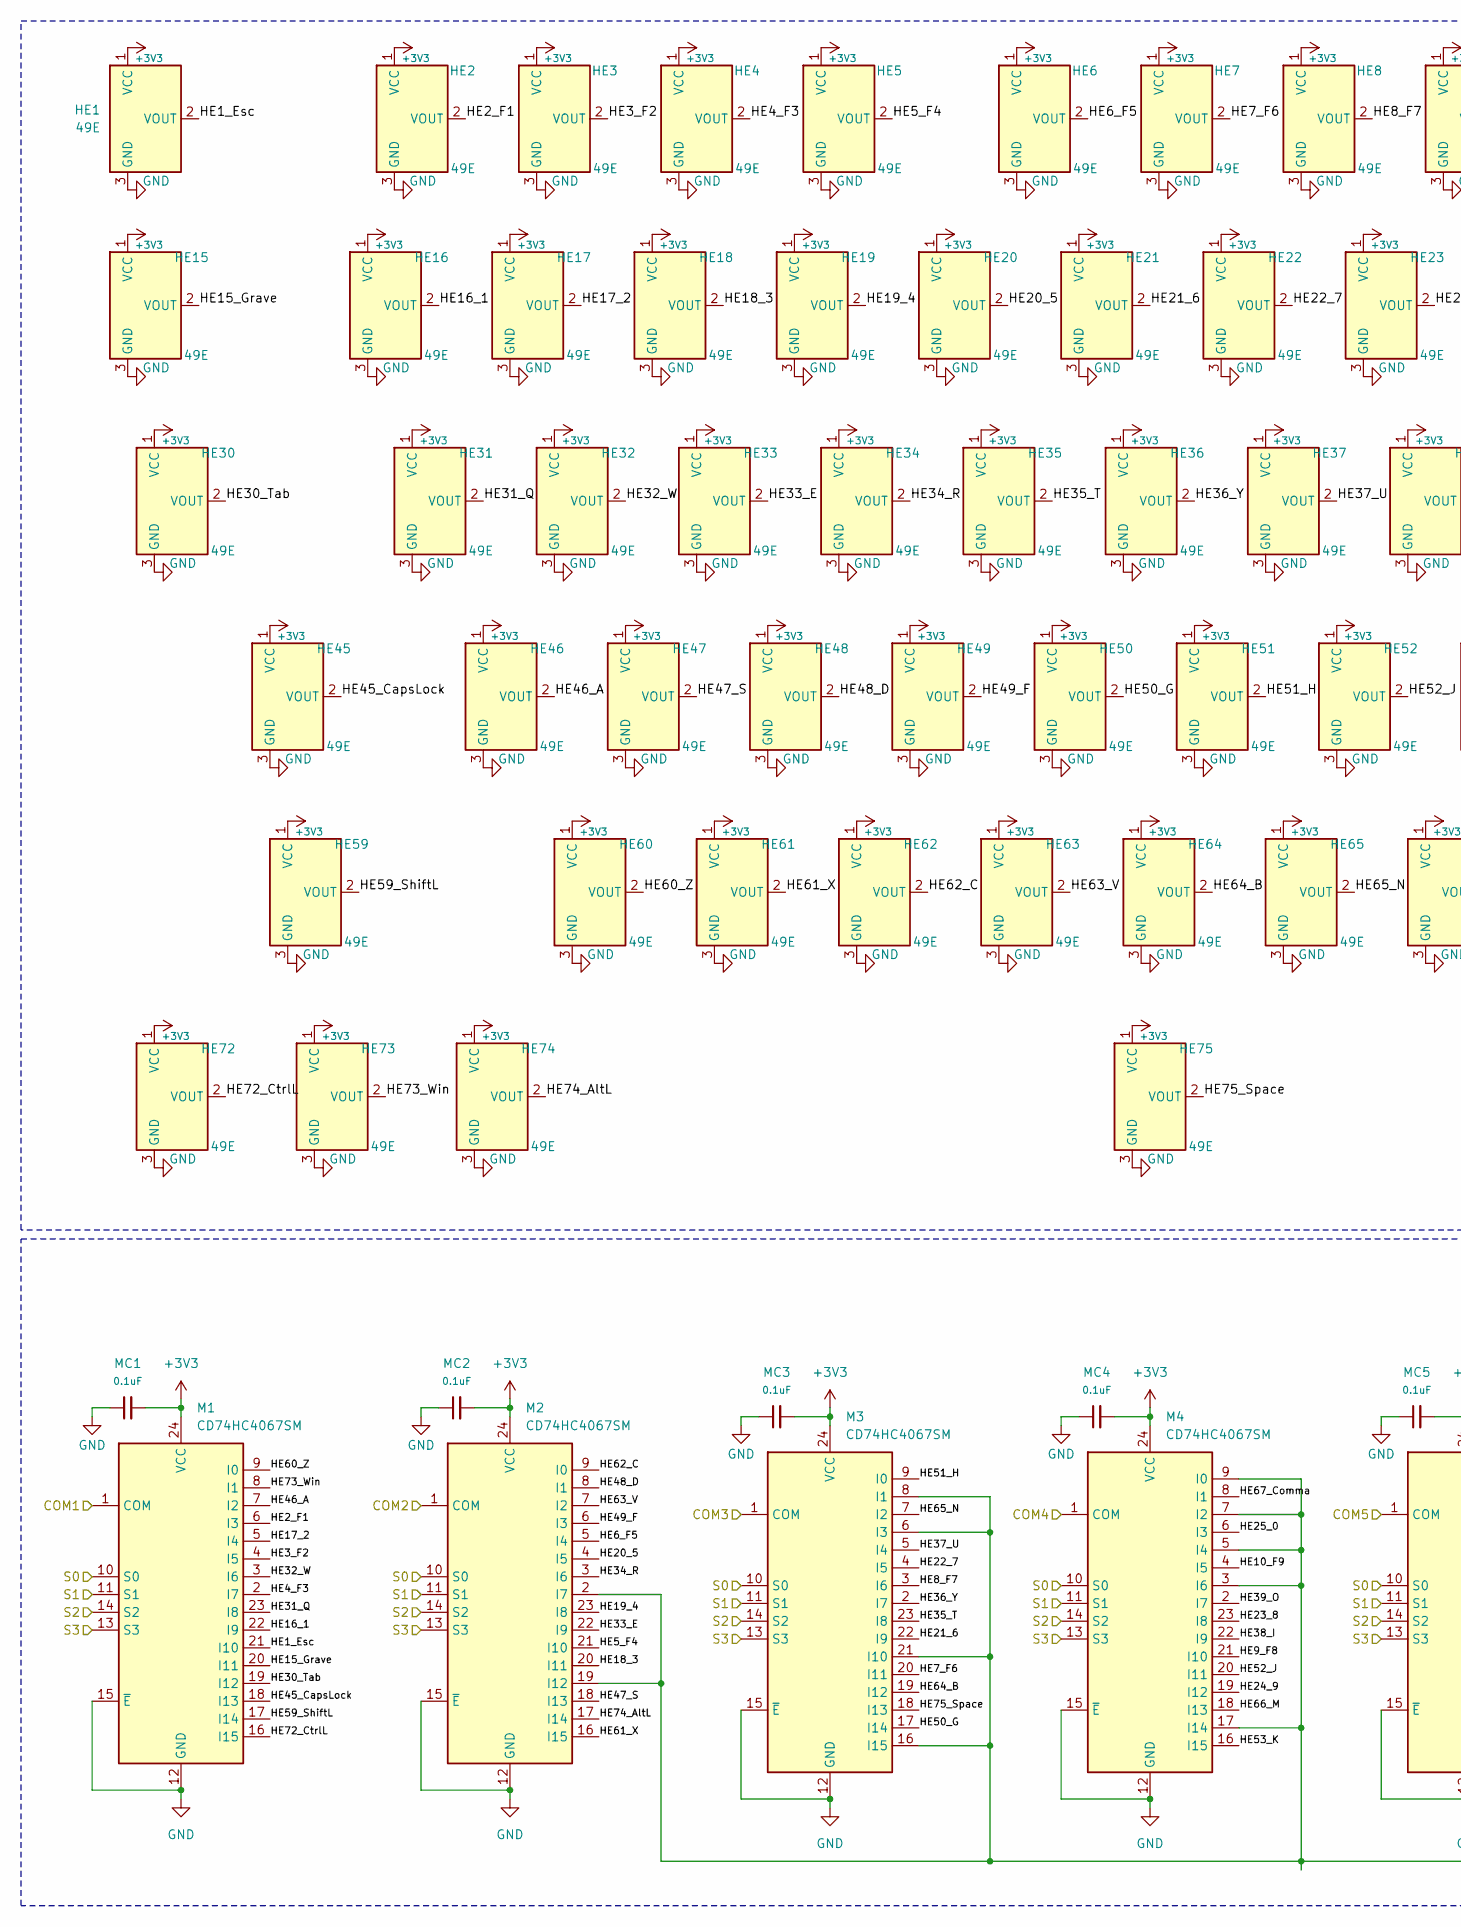
[picture p8: schematic sensors.kicad_sch, part in row 1, column 1]

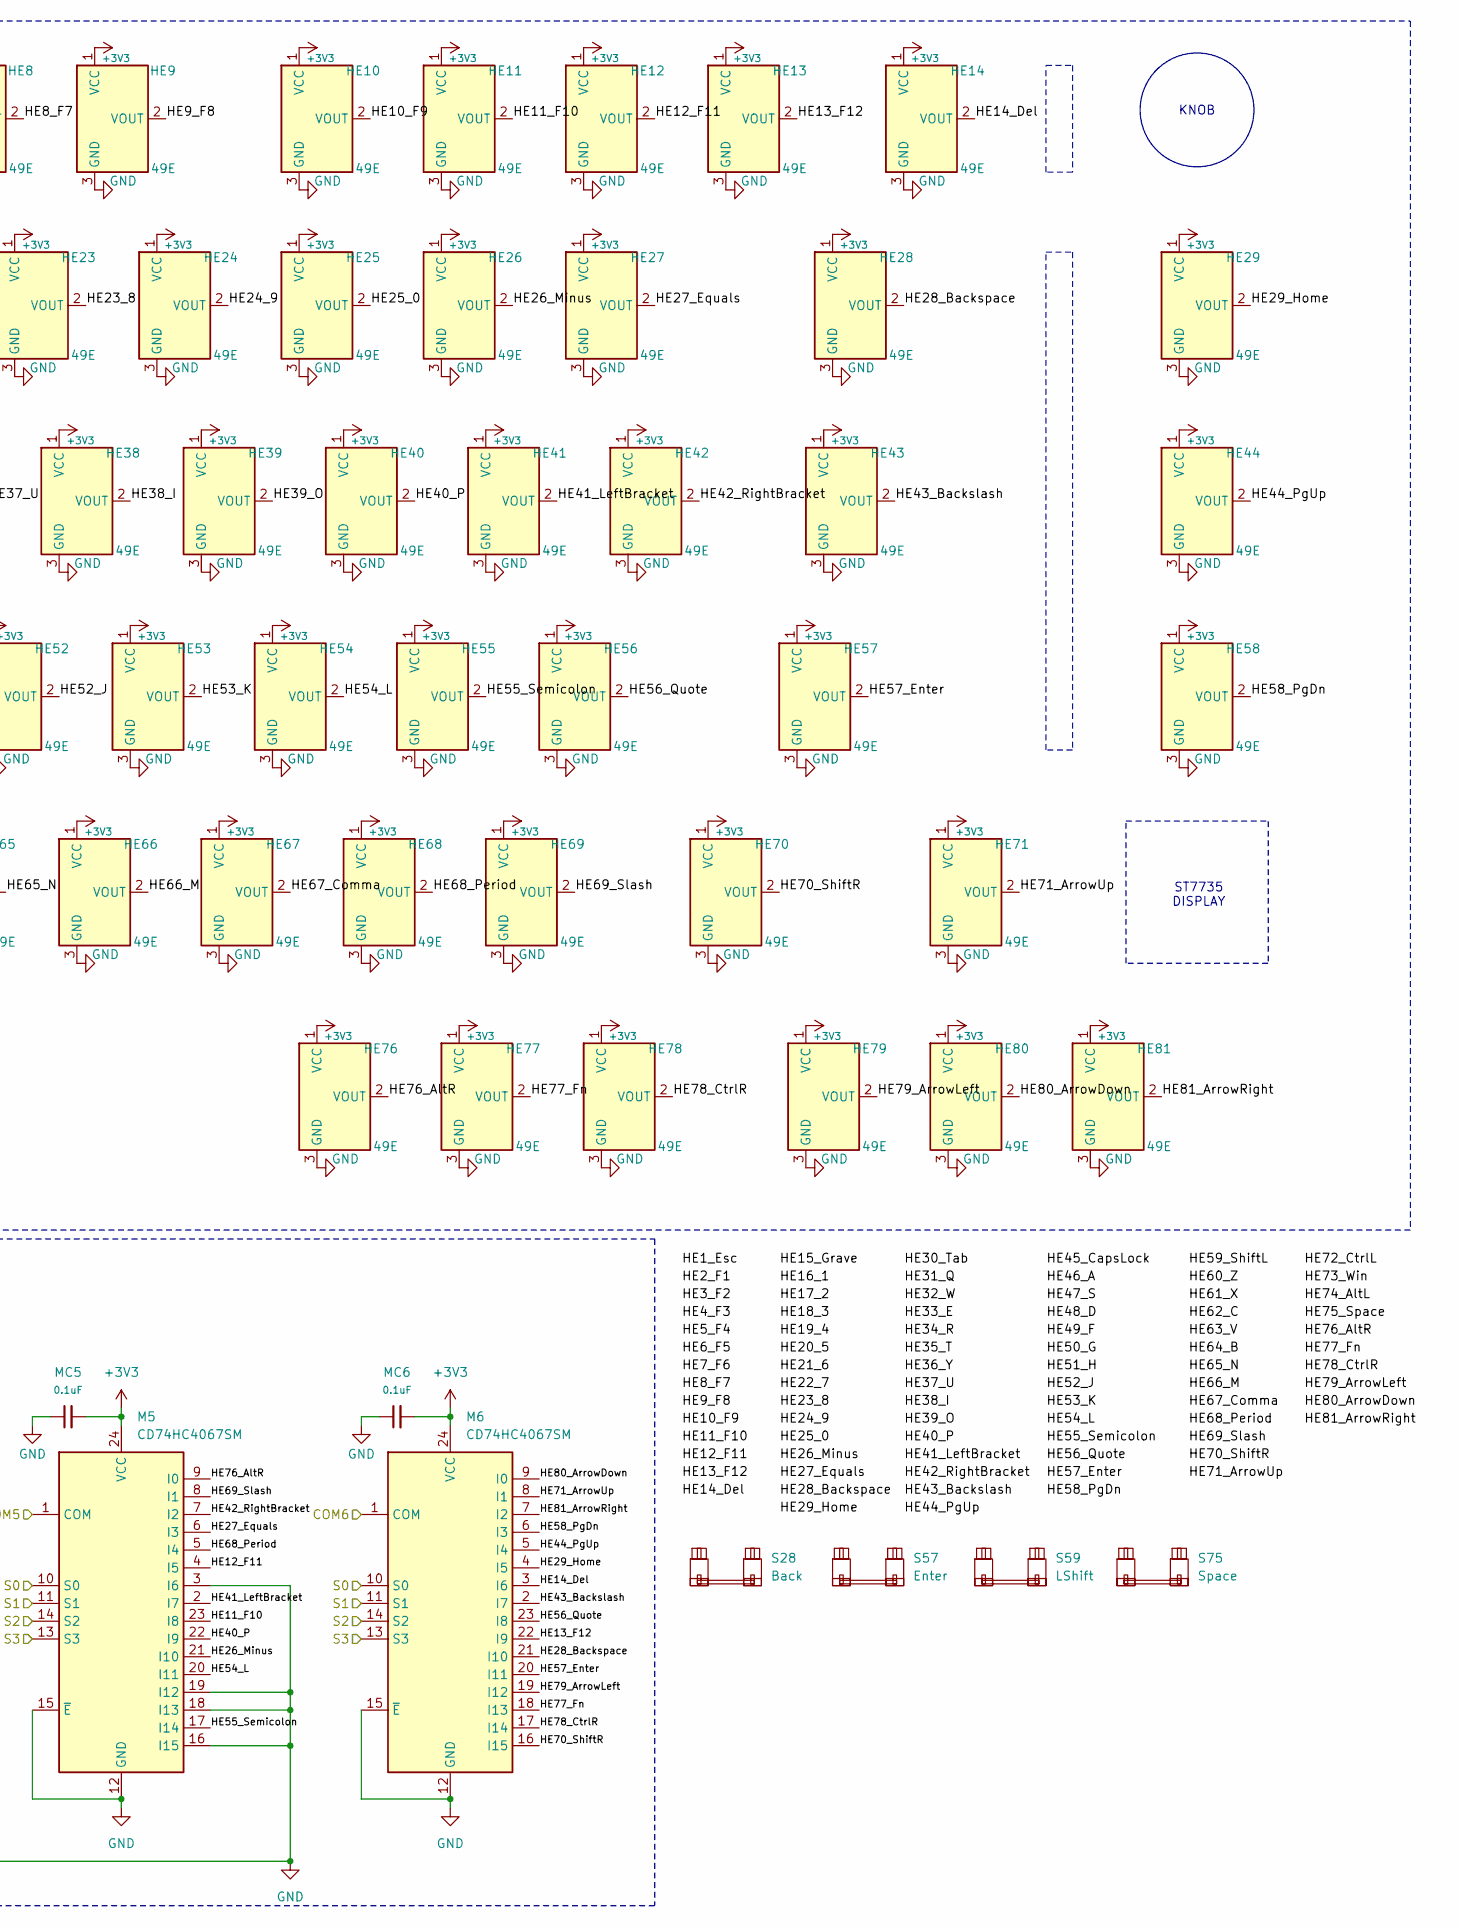
[picture p9: schematic sensors.kicad_sch, part in row 1, column 2]

Parts:
HE1, HE2, HE3, HE4, HE5, HE6, HE7, HE8, HE9, HE10, HE11, HE12, HE13, HE14, HE15, HE16, HE17, HE18, HE19, HE20, HE21, HE22, HE23, HE24, HE25, HE26, HE27, HE29, HE31, HE32, HE33, HE34, HE35, HE36, HE37, HE38, HE39, HE40, HE41, HE42, HE44, HE46, HE47, HE48, HE49, HE50, HE51, HE52, HE53, HE54, HE55, HE56, HE58, HE60, HE61, HE62, HE63, HE64, HE65, HE66, HE67, HE68, HE69, HE71, HE76, HE77, HE78, HE79, HE80, HE81: 49E; SW_MX_HE_90deg_1u_4layer; LCSC C7420984
HE28: 49E; SW_MX_HE_90deg_2.00u_4layer; LCSC C7420984
HE30, HE43: 49E; SW_MX_HE_90deg_1.5u_4layer; LCSC C7420984
HE45, HE70: 49E; SW_MX_HE_90deg_1.75u_4layer; LCSC C7420984
HE57, HE59: 49E; SW_MX_HE_90deg_2.25u_4layer; LCSC C7420984
HE72, HE73, HE74: 49E; SW_MX_HE_90deg_1.25u_4layer; LCSC C7420984
HE75: 49E; SW_MX_HE_90deg_6.25u_4layer; LCSC C7420984
M1, M2, M3, M4, M5, M6: CD74HC4067SM; SSOP-24_5.3x8.2mm_P0.65mm
MC1, MC2, MC3, MC4, MC5, MC6: 0.1uF; C_0402; LCSC C1525
S28: Back; STAB_MX_2u
S57: Enter; STAB_MX_2.25u
S59: LShift; STAB_MX_2.25u
S75: Space; STAB_MX_6.25u

Connections:
+3V3: HE1.1 (VCC), HE2.1 (VCC), HE3.1 (VCC), HE4.1 (VCC), HE5.1 (VCC), HE6.1 (VCC), HE7.1 (VCC), HE8.1 (VCC), HE9.1 (VCC), HE10.1 (VCC), HE11.1 (VCC), HE12.1 (VCC), HE13.1 (VCC), HE14.1 (VCC), HE15.1 (VCC), HE16.1 (VCC), HE17.1 (VCC), HE18.1 (VCC), HE19.1 (VCC), HE20.1 (VCC), HE21.1 (VCC), HE22.1 (VCC), HE23.1 (VCC), HE24.1 (VCC), HE25.1 (VCC), HE26.1 (VCC), HE27.1 (VCC), HE28.1 (VCC), HE29.1 (VCC), HE30.1 (VCC), HE31.1 (VCC), HE32.1 (VCC), HE33.1 (VCC), HE34.1 (VCC), HE35.1 (VCC), HE36.1 (VCC), HE37.1 (VCC), HE38.1 (VCC), HE39.1 (VCC), HE40.1 (VCC), HE41.1 (VCC), HE42.1 (VCC), HE43.1 (VCC), HE44.1 (VCC), HE45.1 (VCC), HE46.1 (VCC), HE47.1 (VCC), HE48.1 (VCC), HE49.1 (VCC), HE50.1 (VCC), HE51.1 (VCC), HE52.1 (VCC), HE53.1 (VCC), HE54.1 (VCC), HE55.1 (VCC), HE56.1 (VCC), HE57.1 (VCC), HE58.1 (VCC), HE59.1 (VCC), HE60.1 (VCC), HE61.1 (VCC), HE62.1 (VCC), HE63.1 (VCC), HE64.1 (VCC), HE65.1 (VCC), HE66.1 (VCC), HE67.1 (VCC), HE68.1 (VCC), HE69.1 (VCC), HE70.1 (VCC), HE71.1 (VCC), HE72.1 (VCC), HE73.1 (VCC), HE74.1 (VCC), HE75.1 (VCC), HE76.1 (VCC), HE77.1 (VCC), HE78.1 (VCC), HE79.1 (VCC), HE80.1 (VCC), HE81.1 (VCC), M1.24 (VCC), M2.24 (VCC), M3.24 (VCC), M4.24 (VCC), M5.24 (VCC), M6.24 (VCC), MC1.2, MC2.2, MC3.2, MC4.2, MC5.2, MC6.2
COM1: M1.1 (COM)
COM2: M2.1 (COM)
COM3: M3.1 (COM)
COM4: M4.1 (COM)
COM5: M5.1 (COM)
COM6: M6.1 (COM)
GND: HE1.3 (GND), HE2.3 (GND), HE3.3 (GND), HE4.3 (GND), HE5.3 (GND), HE6.3 (GND), HE7.3 (GND), HE8.3 (GND), HE9.3 (GND), HE10.3 (GND), HE11.3 (GND), HE12.3 (GND), HE13.3 (GND), HE14.3 (GND), HE15.3 (GND), HE16.3 (GND), HE17.3 (GND), HE18.3 (GND), HE19.3 (GND), HE20.3 (GND), HE21.3 (GND), HE22.3 (GND), HE23.3 (GND), HE24.3 (GND), HE25.3 (GND), HE26.3 (GND), HE27.3 (GND), HE28.3 (GND), HE29.3 (GND), HE30.3 (GND), HE31.3 (GND), HE32.3 (GND), HE33.3 (GND), HE34.3 (GND), HE35.3 (GND), HE36.3 (GND), HE37.3 (GND), HE38.3 (GND), HE39.3 (GND), HE40.3 (GND), HE41.3 (GND), HE42.3 (GND), HE43.3 (GND), HE44.3 (GND), HE45.3 (GND), HE46.3 (GND), HE47.3 (GND), HE48.3 (GND), HE49.3 (GND), HE50.3 (GND), HE51.3 (GND), HE52.3 (GND), HE53.3 (GND), HE54.3 (GND), HE55.3 (GND), HE56.3 (GND), HE57.3 (GND), HE58.3 (GND), HE59.3 (GND), HE60.3 (GND), HE61.3 (GND), HE62.3 (GND), HE63.3 (GND), HE64.3 (GND), HE65.3 (GND), HE66.3 (GND), HE67.3 (GND), HE68.3 (GND), HE69.3 (GND), HE70.3 (GND), HE71.3 (GND), HE72.3 (GND), HE73.3 (GND), HE74.3 (GND), HE75.3 (GND), HE76.3 (GND), HE77.3 (GND), HE78.3 (GND), HE79.3 (GND), HE80.3 (GND), HE81.3 (GND), M1.12 (GND), M1.15 (~E), M2.2 (I7), M2.12 (GND), M2.15 (~E), M2.19 (I12), M3.6 (I3), M3.8 (I1), M3.12 (GND), M3.15 (~E), M3.16 (I15), M3.21 (I10), M4.3 (I6), M4.5 (I4), M4.7 (I2), M4.9 (I0), M4.12 (GND), M4.15 (~E), M4.17 (I14), M5.3 (I6), M5.12 (GND), M5.15 (~E), M5.16 (I15), M5.18 (I13), M5.19 (I12), M6.12 (GND), M6.15 (~E), MC1.1, MC2.1, MC3.1, MC4.1, MC5.1, MC6.1
HE1_Esc: HE1.2 (VOUT), M1.21 (I10)
HE2_F1: HE2.2 (VOUT), M1.6 (I3)
HE3_F2: HE3.2 (VOUT), M1.4 (I5)
HE4_F3: HE4.2 (VOUT), M1.2 (I7)
HE5_F4: HE5.2 (VOUT), M2.21 (I10)
HE6_F5: HE6.2 (VOUT), M2.5 (I4)
HE7_F6: HE7.2 (VOUT), M3.20 (I11)
HE8_F7: HE8.2 (VOUT), M3.3 (I6)
HE9_F8: HE9.2 (VOUT), M4.21 (I10)
HE10_F9: HE10.2 (VOUT), M4.4 (I5)
HE11_F10: HE11.2 (VOUT), M5.23 (I8)
HE12_F11: HE12.2 (VOUT), M5.4 (I5)
HE13_F12: HE13.2 (VOUT), M6.22 (I9)
HE14_Del: HE14.2 (VOUT), M6.3 (I6)
HE15_Grave: HE15.2 (VOUT), M1.20 (I11)
HE16_1: HE16.2 (VOUT), M1.22 (I9)
HE17_2: HE17.2 (VOUT), M1.5 (I4)
HE18_3: HE18.2 (VOUT), M2.20 (I11)
HE19_4: HE19.2 (VOUT), M2.23 (I8)
HE20_5: HE20.2 (VOUT), M2.4 (I5)
HE21_6: HE21.2 (VOUT), M3.22 (I9)
HE22_7: HE22.2 (VOUT), M3.4 (I5)
HE23_8: HE23.2 (VOUT), M4.23 (I8)
HE24_9: HE24.2 (VOUT), M4.19 (I12)
HE25_0: HE25.2 (VOUT), M4.6 (I3)
HE26_Minus: HE26.2 (VOUT), M5.21 (I10)
HE27_Equals: HE27.2 (VOUT), M5.6 (I3)
HE28_Backspace: HE28.2 (VOUT), M6.21 (I10)
HE29_Home: HE29.2 (VOUT), M6.4 (I5)
HE30_Tab: HE30.2 (VOUT), M1.19 (I12)
HE31_Q: HE31.2 (VOUT), M1.23 (I8)
HE32_W: HE32.2 (VOUT), M1.3 (I6)
HE33_E: HE33.2 (VOUT), M2.22 (I9)
HE34_R: HE34.2 (VOUT), M2.3 (I6)
HE35_T: HE35.2 (VOUT), M3.23 (I8)
HE36_Y: HE36.2 (VOUT), M3.2 (I7)
HE37_U: HE37.2 (VOUT), M3.5 (I4)
HE38_I: HE38.2 (VOUT), M4.22 (I9)
HE39_O: HE39.2 (VOUT), M4.2 (I7)
HE40_P: HE40.2 (VOUT), M5.22 (I9)
HE41_LeftBracket: HE41.2 (VOUT), M5.2 (I7)
HE42_RightBracket: HE42.2 (VOUT), M5.7 (I2)
HE43_Backslash: HE43.2 (VOUT), M6.2 (I7)
HE44_PgUp: HE44.2 (VOUT), M6.5 (I4)
HE45_CapsLock: HE45.2 (VOUT), M1.18 (I13)
HE46_A: HE46.2 (VOUT), M1.7 (I2)
HE47_S: HE47.2 (VOUT), M2.18 (I13)
HE48_D: HE48.2 (VOUT), M2.8 (I1)
HE49_F: HE49.2 (VOUT), M2.6 (I3)
HE50_G: HE50.2 (VOUT), M3.17 (I14)
HE51_H: HE51.2 (VOUT), M3.9 (I0)
HE52_J: HE52.2 (VOUT), M4.20 (I11)
HE53_K: HE53.2 (VOUT), M4.16 (I15)
HE54_L: HE54.2 (VOUT), M5.20 (I11)
HE55_Semicolon: HE55.2 (VOUT), M5.17 (I14)
HE56_Quote: HE56.2 (VOUT), M6.23 (I8)
HE57_Enter: HE57.2 (VOUT), M6.20 (I11)
HE58_PgDn: HE58.2 (VOUT), M6.6 (I3)
HE59_ShiftL: HE59.2 (VOUT), M1.17 (I14)
HE60_Z: HE60.2 (VOUT), M1.9 (I0)
HE61_X: HE61.2 (VOUT), M2.16 (I15)
HE62_C: HE62.2 (VOUT), M2.9 (I0)
HE63_V: HE63.2 (VOUT), M2.7 (I2)
HE64_B: HE64.2 (VOUT), M3.19 (I12)
HE65_N: HE65.2 (VOUT), M3.7 (I2)
HE66_M: HE66.2 (VOUT), M4.18 (I13)
HE67_Comma: HE67.2 (VOUT), M4.8 (I1)
HE68_Period: HE68.2 (VOUT), M5.5 (I4)
HE69_Slash: HE69.2 (VOUT), M5.8 (I1)
HE70_ShiftR: HE70.2 (VOUT), M6.16 (I15)
HE71_ArrowUp: HE71.2 (VOUT), M6.8 (I1)
HE72_CtrlL: HE72.2 (VOUT), M1.16 (I15)
HE73_Win: HE73.2 (VOUT), M1.8 (I1)
HE74_AltL: HE74.2 (VOUT), M2.17 (I14)
HE75_Space: HE75.2 (VOUT), M3.18 (I13)
HE76_AltR: HE76.2 (VOUT), M5.9 (I0)
HE77_Fn: HE77.2 (VOUT), M6.18 (I13)
HE78_CtrlR: HE78.2 (VOUT), M6.17 (I14)
HE79_ArrowLeft: HE79.2 (VOUT), M6.19 (I12)
HE80_ArrowDown: HE80.2 (VOUT), M6.9 (I0)
HE81_ArrowRight: HE81.2 (VOUT), M6.7 (I2)
S0: M1.10 (S0), M2.10 (S0), M3.10 (S0), M4.10 (S0), M5.10 (S0), M6.10 (S0)
S1: M1.11 (S1), M2.11 (S1), M3.11 (S1), M4.11 (S1), M5.11 (S1), M6.11 (S1)
S2: M1.14 (S2), M2.14 (S2), M3.14 (S2), M4.14 (S2), M5.14 (S2), M6.14 (S2)
S3: M1.13 (S3), M2.13 (S3), M3.13 (S3), M4.13 (S3), M5.13 (S3), M6.13 (S3)

Notes on the sheet:
KNOB
ST7735 DISPLAY
