Charading/VLT/(commit log)

2026-02-06 Initial VLT hardware
    [VLT.kicad_sch, VLT_plate.dxf, leds.kicad_sch, sensors.kicad_sch]
2026-02-22 Changed encoder pinout A: GP16>GP15, B: GP14>GP15, SW: GP15>GP16
    [VLT.kicad_sch]
2026-02-22 Changed WS2812B pin. RGB_DATA_IN: GP3>GP21
    [VLT.kicad_sch]
2026-02-22 Remapped pins, added MPR121
    [VLT.kicad_sch]
2026-02-23 Implemented multiple leds for spacebar
    [leds.kicad_sch]
2026-02-27 Rev 2: Major PCB rework — haptic motor, MicroSD, NTC, CTP, split spacebar
    - Added ERM haptic motor with BSS138 MOSFET driver on GP21
    - Added MicroSD card slot (MSD-1-A, push-in/auto-eject)
    - Added NTC thermistor with voltage divider
    - Added 4-pin 0.5mm FPC connector for capacitive touch panel
    - Added ferrite beads (0603 600R, 0805) for power filtering
    - Added 1N4148WT protection diode and test point
    - Split spacebar support: HE45 alternate 1.75u stabilizer footprint
    - Full PCB re-route with 4-layer switch footprints
    - All 81 hall sensors relabeled with key names in schematic
    - Relaxed DRC (text height, via diameter), new via size 0.6/0.2
    - Added CHANGELOG.md and wiring.cpp MUX mapping refe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
    [VLT.kicad_sch, leds.kicad_sch, sensors.kicad_sch]
2026-02-28 VLT_rev1 PCB complete — production files added
    Finalized schematic and PCB layout. Added production/ with
    Gerbers (VLT_rev1.zip), BOM, pick-and-place positions, and
    IPC netlist for fabrication.
    [VLT.kicad_sch, VLT_rev1_bom.csv, VLT_rev1_designators.csv, VLT_rev1_positions.csv, sensors.kicad_sch]
2026-03-02 VLT PCB rev: dual TFT connector, RKJXT1F42001 footprint, LED expansion header
    - Add 12-pin TFT connector alongside existing 8-pin for CTP-integrated display option
    - Superimpose RKJXT1F42001 5-way joystick footprint on EC11 encoder for testing
    - Add LED expansion header for additional RGB zones
    - Update production files
    [VLT.kicad_sch, VLT_rev1_bom.csv, VLT_rev1_designators.csv, VLT_rev1_positions.csv, leds.kicad_sch, sensors.kicad_sch]
2026-03-02 Resave schematic
    [VLT.kicad_sch]
2026-03-25 Mark RP2350B revisions obsolete, add Rev 3 with STM32H723VGT6 + 16MB flash
2026-04-27 CAD: add drawings — self-clinch standoff, LED cutout, knurl
    - SelfClinchStandoff.dwg/png: standoff geometry for case design
    - led cUTOUT.dxf: KiCad import for new LED footprint hole shape
    - standoff-knurl.svg: OnShape import for knurled standoff dimensions
    [SelfClinchStandoff.dwg, led cUTOUT.dxf]
2026-04-27 PCB rev1 done — schematic/layout updates, drop stale production exports
    - Schematic + PCB updates across VLT.kicad_pcb/sch, leds.kicad_sch, sensors.kicad_sch
    - Remove production/ rev1 exports (zip/bom/positions/netlist) — regenerated on demand
    - Drop fabrication-toolkit-options.json (not used)
    - gitignore VLT+Dev/ experimental layouts
    [VLT.kicad_sch, VLT_rev1_bom.csv, VLT_rev1_designators.csv, VLT_rev1_positions.csv, leds.kicad_sch, sensors.kicad_sch]
